ma-t-thias/ESP32-LED-Kopfhoererstaender/docs/hardware/schaltung.html

Projekt Arduino Kopfhörer · Schritt 1 Hardware

# WLED-Steuerung für den Kopfhörerständer: Schaltung und Bauteile

Waveshare ESP32-C6-Touch-LCD-1.9 steuert einen WS2812B-Streifen (5 V, 144 LEDs/m, später auf 60 bis 70 cm gekürzt) per WLAN. Versorgung über ein USB-C-Netzteil 5 V / 3 A. Aufbau auf zwei 400-Punkte-Breadboards BB-801, übereinander gesteckt. Pinbelegung geprüft gegen den Waveshare-Schaltplan des ESP32-C6-Touch-LCD-1.9 (Stiftleisten J3 und J4).

## Die fünf Entscheidungen

Datenpin GPIO3J3 Pin 7. Kein Strapping-Pin, nicht von LCD, SD, Touch, IMU oder USB belegt. GPIO1 und GPIO2 sind auf diesem Board die Interrupts des Lagesensors.

LED-Strom nie übers BreadboardBis zu 3 A fließen direkt USB-C-Buchse → WAGO → Streifen. Das Breadboard bekommt nur Signal und Logikversorgung.

Pegelwandler 74AHCT125Hebt das 3,3-V-Signal auf 5 V. WS2812B erwartet ab 0,7 × VDD = 3,5 V ein sicheres High.

Aura über Kabel an GPIO23Der ESP liest das ARGB-Signal des Mainboard-Headers mit. Ohne Signal laufen die eigenen Effekte.

Schottky-Diode vor dem VBUS-PinDer VBUS-Pin des Boards (J4 Pin 1) hängt direkt an USB-VBUS. D1 verhindert, dass das USB-C-Netzteil in den PC zurückspeist.

## Schaltplan

Das USB-C-Netzteil versorgt den Streifen direkt. Der ESP32 bekommt seine 5 V über D1, das Datensignal läuft von GPIO3 durch einen Puffer des 74AHCT125 und R1 zum DIN des Streifens. Alle Massen sind verbunden.

## Breadboard-Belegung (2 × BB-801)

+5 V GND GPIO3 (3,3 V) Daten 5 V zum Streifen ARGB-Daten vom Mainboard Dicke Linien rechts = Litze ≥ 1,0 mm²

Zwei Breadboards übereinander, Board 1 oben, Board 2 darunter. Reihen 1–30 von links nach rechts, Spalten j (oben) bis a (unten). Jede Reihe ist pro Hälfte (a–e und f–j) leitend verbunden. Der ESP überspannt beide Boards in den Reihen 1 bis 20: Display nach oben, USB-C-Anschluss Richtung Reihe 1, Stiftleiste J4 in Board 1 Spalte a, J3 in Board 2 Spalte j. Unter dem Display bleiben pro Reihe nur die freien Löcher Board 1 e (für J4) und Board 2 f (für J3) erreichbar, gelb markiert. Die Steuerung sitzt auf Board 1. Die USB-C-Buchse steckt auf Board 2 in Spalte a, Reihe 23 (GND) bis 30 (CC2), die Platine ragt über die untere Schiene. Der 74AHCT125 sitzt in den Reihen 23 bis 29 und überbrückt den Mittelkanal mit der Kerbe Richtung Reihe 29. Reihe 21 und 22 tragen den Spannungsteiler für das ARGB-Signal.

Vor dem Einstecken prüfen: Die beiden Stiftleisten liegen 17,78 mm (7 Rastermaße) auseinander, das passt genau auf Board 1 Spalte a und Board 2 Spalte j, wenn die Boards direkt aneinander stecken. Die M2-Abstandsbolzen (4 mm) auf der Rückseite begrenzen die Einstecktiefe, die Stifte greifen trotzdem sicher. Wenn es nicht sauber sitzt: Board neben das Breadboard legen und nur VBUS, GND, IO3 und IO23 mit vier Dupont-Kabeln (Buchse–Stecker) in Board 1 e1, e3, e9 und Board 2 f7 führen. Elektrisch ist das identisch. Kontrolliere außerdem die Aufschrift: In Board 1, Reihe 1, Spalte a muss der Pin „VBUS“ stecken (J4 Pin 1, direkt neben der USB-C-Buchse). Die USB-C-Buchse steckt nur zur Halterung im Breadboard. Die Litze für VBUS und GND lötest du oben an die Stifte der Buchse, so fließt der LED-Strom nicht über die Breadboard-Kontakte. Board 2, Reihe 23 und 24 (Spalte b bis e) liegen dadurch auf GND und 5 V, dort nichts anderes einstecken.

Von | Nach | Leitung | Zweck
ESP VBUS (J4/1, Board 1 a1) | D1 Kathode (Ring) in e1, Anode in f1 (über den Mittelkanal), j1 → obere + Schiene | Diode | ESP-Versorgung ohne Rückspeisung
ESP GND (J4/3, Board 1 a3) | e3 → obere − Schiene | blau | Gemeinsame Masse
ESP IO3 (J3/7, Board 2 j7) | Board 2 f7 → rechts am Display vorbei → Board 1 g28 (U1 Pin 2, 1A) | gelb | Datensignal 3,3 V
U1 Pin 3, 1Y (f27) | R1 330 Ω von h27 nach h30 | Widerstand | Dämpft Reflexionen, schützt DIN
j30 | Streifen DIN | grün | Datensignal 5 V
U1 Pin 1, 1OE̅ (f29) | j29 → obere − Schiene | blau | Kanal 1 dauerhaft aktiv
U1 Pin 7, GND (f23) | j23 → obere − Schiene | blau | IC-Masse
U1 Pin 14, VCC (e29) | a29 → untere + Schiene | rot | IC-Versorgung 5 V
C2 100 nF | b29 ↔ untere − Schiene | Kondensator | Abblockung direkt am IC
U1 Pin 4 (f26) / 10 (e25) / 13 (e28) | j26, a25, a28 → + Schiene | rot | Unbenutzte Kanäle abschalten
U1 Pin 5 (f25) / 9 (e24) / 12 (e27) | j25, a24, a27 → − Schiene | blau | Unbenutzte Eingänge nicht offen lassen
C1 1000 µF | + Bein in obere + Schiene, − Bein (Streifen) in obere − Schiene (Reihe 11/12) | Elko | Puffert Einschaltstrom und Lastsprünge
ESP IO23 (J4/9, Board 1 a9) | e9 → h21 | lila | ARGB-Eingang, Knoten des Spannungsteilers
Mainboard-ARGB D | i22, dann R3 1 kΩ von g22 nach g21 | lila | Aura-Signal, 5 V auf ca. 3,3 V geteilt
R4 2 kΩ | j21 → obere − Schiene | Widerstand | Unterer Teil des Spannungsteilers
Mainboard-ARGB G | obere − Schiene (Reihe 24) | grau | Gemeinsame Masse mit dem PC. Den 5V-Pin des Headers nicht anschließen.
obere Schienen | untere Schienen (+ zu +, − zu −) rechts ums Board | rot / blau | Beide Seiten versorgen
WAGO +5V / GND | obere + Schiene (Reihe 28) / obere − Schiene (Reihe 27) | dünn | Logikversorgung, unter 0,4 A
USB-C VBUS / GND (Board 2 a24 / a23) | oben an die Stifte gelötet → WAGO +5V / GND | Litze ≥ 1,0 mm² | Einspeisung, bis 3 A
USB-C D− / D+ (Board 2 a27 / a28) optional | e27 → f11 (ESP IO12, J3/11), e28 → f12 (ESP IO13, J3/12) | hellblau, gestrichelt | Nur für PC-Sync über USB (Adalight, siehe README). Dann den ESP nicht gleichzeitig über seine eigene USB-Buchse am PC haben.
WAGO +5V / GND | Streifen +5V / GND | Litze ≥ 1,0 mm² | LED-Strom bis 3 A

## Bauteilliste

Pos. | Bauteil | Wert / Typ | Menge | Dimensionierung und Hinweis
1 | Mikrocontroller vorhanden | Waveshare ESP32-C6-Touch-LCD-1.9 (Art.-Nr. 30941), Stiftleisten eingelötet | 1 | Zieht mit WLAN-Spitzen bis ca. 0,35 A.
2 | LED-Streifen vorhanden | WS2812B, 5 V, 144 LEDs/m, 1 m, IP30 | 1 | Wird auf 60 bis 70 cm gekürzt (ca. 86 bis 101 LEDs), nur an den Schnittmarken trennen. Max. ca. 60 mA pro LED bei vollem Weiß, ca. 1 mA pro LED auch im ausgeschalteten Zustand.
3 | Breadboard vorhanden | BB-801, 400 Kontakte | 2 | Übereinander gesteckt, weil das Display seitlich übersteht. Kontakte vertragen ca. 1 A. Deshalb kein LED-Strom über das Breadboard.
4 | USB-C-Netzteil | 5 V / 3 A (15 W), USB-C, z. B. offizielles Raspberry-Pi-4-Netzteil (5,1 V / 3 A) | 1 | Ein normales USB-C-Ladegerät mit 5 V / 3 A geht auch. Wichtig ist 3 A bei 5 V, viele Handy-Ladegeräte liefern bei 5 V nur 2 A. Strombegrenzung in der Firmware auf 2400 mA.
5 | Pegelwandler U1 | 74AHCT125N (DIP-14) | 1 | Gleichwertig: 74HCT125N oder 74HCT245N. Kein 74HC125 (falsche Eingangsschwelle) und kein MOSFET-Modul für I²C (zu langsam für 800 kHz).
6 | Widerstand R1 | 330 Ω, 0,25 W | 1 | Zulässig 220 bis 470 Ω. Im Endaufbau möglichst nah an den Streifen setzen.
7 | Elko C1 | 1000 µF, ≥ 10 V, radial | 1 | Polung beachten: Streifen am Gehäuse = Minus. Im Endaufbau direkt an den Streifeneingang löten.
8 | Keramikkondensator C2 | 100 nF | 1 | Abblockkondensator am 74AHCT125, so nah wie möglich an Pin 14.
9 | Schottky-Diode D1 | 1N5819 (oder 1N5817), 1 A | 1 | Ring (Kathode) zum ESP. Der ESP bekommt dann ca. 4,7 V, das reicht für seinen 3,3-V-Regler.
10 | USB-C-Buchse (Power-Breakout) vorhanden | QUARKZMAN USB-C-Breakout, 8 Stifte im 2,54-mm-Raster: GND, VBUS, SBU2, CC1, D−, D+, SBU1, CC2. 5,1 kΩ an CC1 und CC2 sind auf der Platine (Aufdruck „512“). | 1 | Gekauft bei Amazon B0CJC5M66Q (https://www.amazon.de/dp/B0CJC5M66Q). Ohne die CC-Widerstände schaltet ein USB-C-Netzteil keine Spannung ein. Beim Kauf auf „5,1 kΩ“ oder „CC-Widerstände“ achten, die einfachen 2-Pin-Platinen haben sie oft nicht. Kein PD-Trigger nötig.
11 | Verbindungsklemmen | WAGO 221-413 (3-fach) | 2 | Je eine für +5 V und GND: USB-C-Buchse, Streifen, Breadboard.
12 | Litze | 1,0 mm² (AWG 18), rot und schwarz | je 0,5 m | Für den Strompfad USB-C-Buchse → Streifen. 0,75 mm² reicht bei 3 A auch.
13 | Steckverbinder Streifen | JST-SM 3-polig, Gegenstück zum Eingang | 1 | Optional, wenn du die offenen Litzen am Streifen nicht direkt in die WAGO-Klemme führen willst.
14 | Steckbrücken | Jumper Stecker–Stecker, Drahtbrückenset | ca. 18 | Plus 4 × Buchse–Stecker als Reserve für die Variante „Board neben dem Breadboard“.
15 | ARGB-Kabel | 3-polige ARGB-Verlängerung (5V, D, G) mit Buchse für den Mainboard-Header | 1 | Ende abschneiden, nur D und G nutzen. So steuert ASUS Aura den Ständer.
16 | Widerstände R3, R4 | 1 kΩ und 2 kΩ | je 1 | Spannungsteiler: 5 V × 2 / 3 = 3,3 V am GPIO23. Ersatzweise 3 × 1 kΩ, zwei davon in Reihe als 2 kΩ.
17 | Sicherung optional | Feinsicherung oder KFZ-Flachsicherung 4 A mit Halter | 1 | In die +5-V-Leitung nach der USB-C-Buchse. USB-C-Netzteile schalten bei Überlast meist selbst ab.

## Netzteil-Dimensionierung

≈ 6 A100 LEDs (70 cm) × 60 mA, Vollweiß 100 %

≈ 0,35 AESP32-C6 mit WLAN-Spitzen

2,4 AStrombegrenzung bei 5 V / 3 A, Rest für ESP und Reserve

0,5–2 ATypischer Bedarf bei Farbverläufen und Effekten

Die Firmware begrenzt die Helligkeit so, dass der berechnete Strom 2400 mA nicht überschreitet (WLED nennt das „Automatic Brightness Limiter“). Farbige Effekte laufen damit in voller Helligkeit. Nur Vollweiß auf allen LEDs wird auf etwa 40 % gedimmt. Wer mehr will, nimmt ein USB-C-PD-Ladegerät (30 bis 65 W) mit PD-Trigger auf 12 V und einen Step-down-Wandler auf 5 V mit mindestens 6 A, die Strombegrenzung dann auf etwa 85 % des Wandlerstroms.

## Prüfen vor dem ersten Einschalten

1. Ohne ESP, IC und Streifen: USB-C-Netzteil einstecken und an den Schienen messen. Erwartet sind 4,9 bis 5,25 V. Liegt 0 V an, fehlen der Buchse die CC-Widerstände. Plus oben und unten an der roten Linie.
2. 74AHCT125 einsetzen: Pin 14 gegen Pin 7 muss 5 V zeigen. Kerbe zeigt Richtung Reihe 29.
3. D1 kontrollieren: Ring in Board 1 e1, Anode in f1. Mit USB-C-Netzteil an und ohne USB am ESP misst du an e1 ca. 4,7 V.
4. C1-Polung kontrollieren: Minus-Streifen auf der blauen Schiene.
5. Streifen am Eingang anschließen: Die Pfeile auf dem Streifen zeigen vom DIN-Ende weg.
6. Reihenfolge beim Anschließen: zuerst GND und +5 V, dann die Datenleitung. Das Datensignal nie an einen unversorgten Streifen legen.
7. Zum Flashen darfst du die USB-Buchse des ESP und das USB-C-Netzteil gleichzeitig verbinden. D1 sperrt dann, der ESP läuft über USB, die Massen sind über die gemeinsame GND-Schiene verbunden.

## Pinbelegung des Boards (aus dem Waveshare-Schaltplan)

Leiste | Pins | Verwendung hier
J4 (Board 1 Spalte a) | 1 VBUS · 2 VSYS · 3 GND · 4 3V3_EN · 5 3V3 · 6 ADC_VREF · 7 IO22 · 8 GND · 9 IO23 · 10 EXIO0 · 11 RUN · 12 EXIO1 · 13 GND · 14–17 EXIO2–5 · 18 GND · 19–20 EXIO6–7 | Pin 1 VBUS über D1, Pin 3 GND, Pin 9 IO23 = ARGB-Eingang vom Mainboard. EXIO sind Ausgänge des I²C-Expanders TCA9554, für WS2812B nicht geeignet.
J3 (Board 2 Spalte j) | 1 IO16 · 2 IO17 · 3 GND · 4 IO0 · 5 IO1 · 6 IO2 · 7 IO3 · 8 GND · 9 IO8 · 10 IO9 · 11 IO12 · 12 IO13 · 13 GND · 14 IO14 · 15 IO15 · 16 IO18 · 17 IO19 · 18 GND · 19 IO20 · 20 IO21 | Pin 7 IO3 = LED-Daten. 16/17 UART0, 12/13 USB, 0 Akku-ADC, 1/2 IMU-Interrupt, 8/18 Touch-I²C, 9/15 Strapping, 14/15 LCD, 19/20 SD-Karte. Nicht benutzen.
Intern belegt | LCD 4/5/6/7/14/15 · Touch + IMU I²C 8/18 · IMU-INT 1/2 · SD 19/20 · BOOT 9 | Pin 1 beider Leisten liegt an der USB-C-Seite.

Stand 7. November 2026. Board: ESP32-C6-Touch-LCD-1.9, LED-Daten an GPIO3, ARGB-Eingang an GPIO23.
