ma-t-thias/ESP32-LED-Kopfhoererstaender/docs/hardware/platine/out/platine_aetzvorlage_A4.pdf

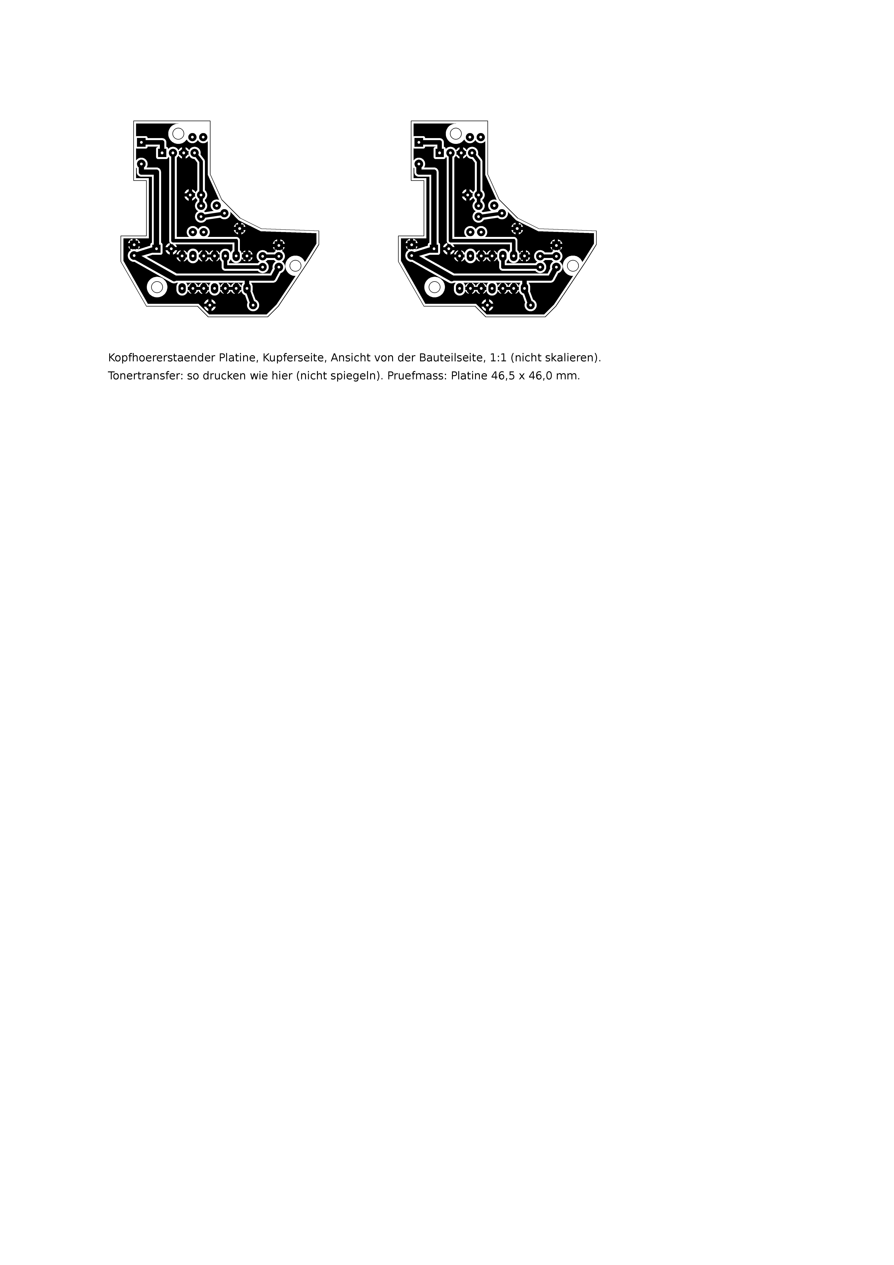
[picture p34: page 1]
