ma-t-thias/ESP32-LED-Kopfhoererstaender/docs/hardware/gehaeuse/c6-lcd-1.3/bilder/view_front.png

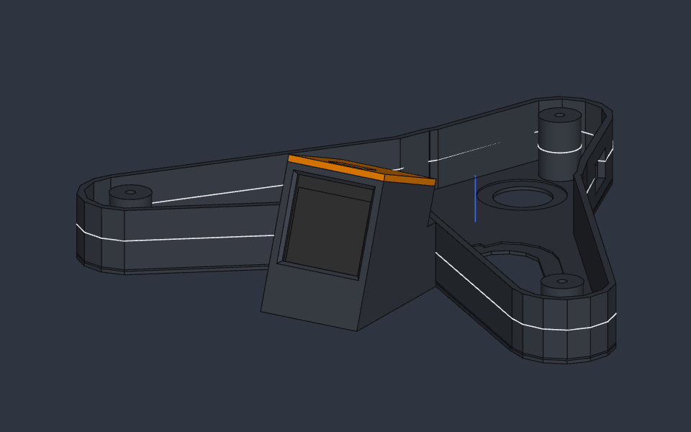
docs/hardware/gehaeuse/c6-lcd-1.3/bilder/view_front.png
