ma-t-thias/ESP32-LED-Kopfhoererstaender/docs/hardware/gehaeuse/c6-lcd-1.3/bilder/view_section_rail.png

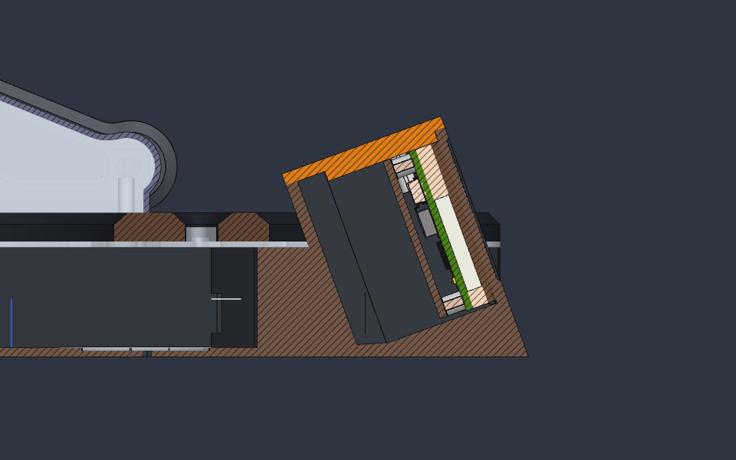
docs/hardware/gehaeuse/c6-lcd-1.3/bilder/view_section_rail.png
