ma-t-thias/ESP32-LED-Kopfhoererstaender/docs/hardware/gehaeuse/c6-touch-1.9/hochkant/bilder/asm_section.png

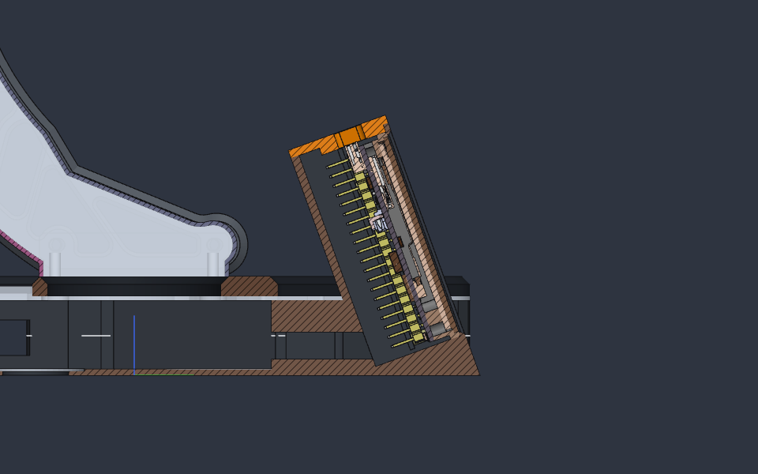
docs/hardware/gehaeuse/c6-touch-1.9/hochkant/bilder/asm_section.png
