ma-t-thias/ESP32-LED-Kopfhoererstaender/docs/hardware/gehaeuse/c6-touch-1.9/quer/bilder/quer_frontb_front.png

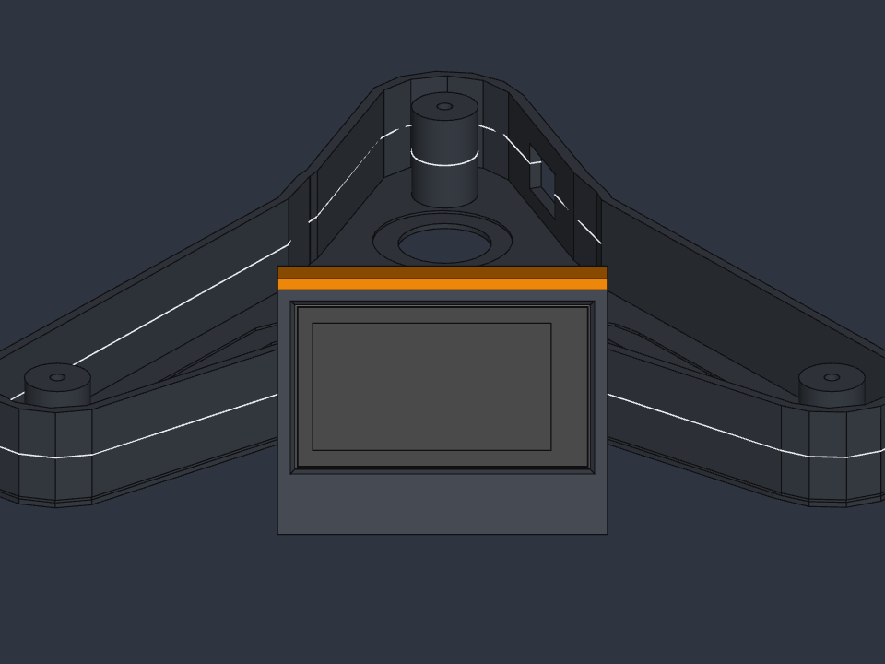
docs/hardware/gehaeuse/c6-touch-1.9/quer/bilder/quer_frontb_front.png
