ma-t-thias/ESP32-LED-Kopfhoererstaender/docs/hardware/gehaeuse/staender-v2/entwurf-1/Auflage_v2_schnitt.png

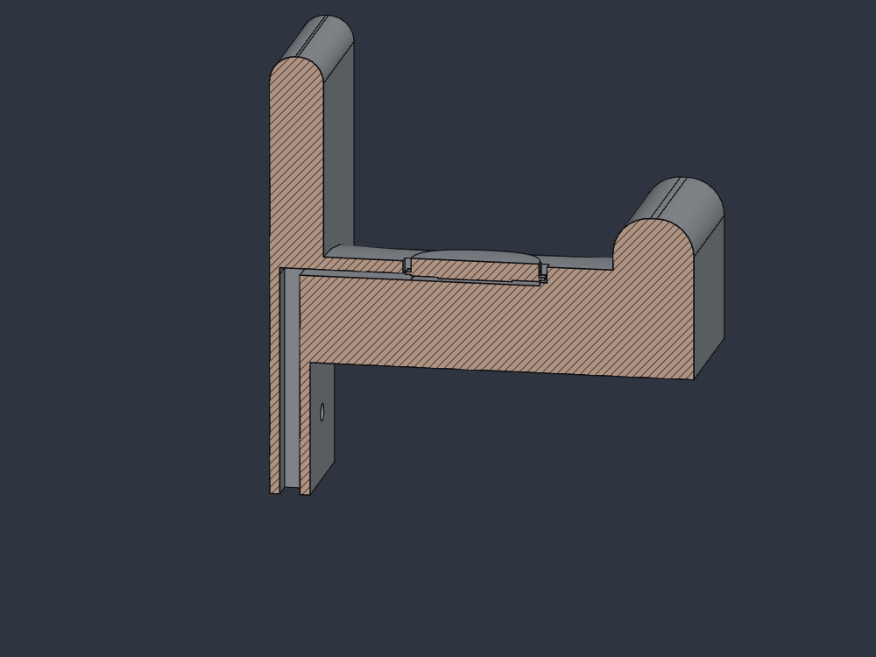
docs/hardware/gehaeuse/staender-v2/entwurf-1/Auflage_v2_schnitt.png
