ma-t-thias/ESP32-LED-Kopfhoererstaender/docs/hardware/gehaeuse/staender-v2/entwurf-1/Deckel_Mikrohalter_innen.png

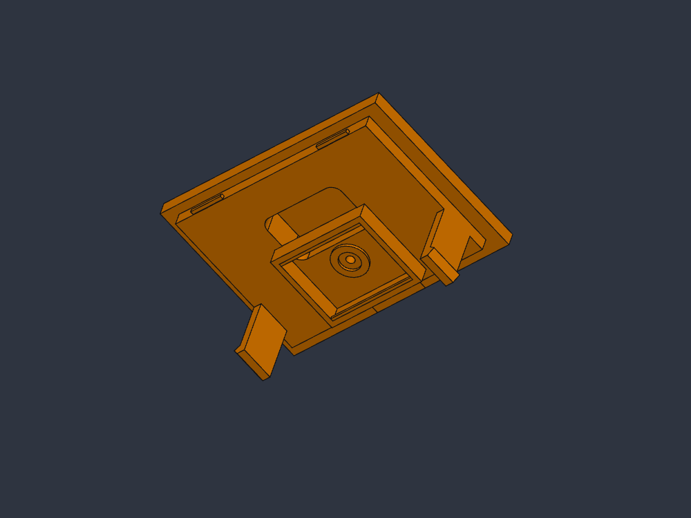
docs/hardware/gehaeuse/staender-v2/entwurf-1/Deckel_Mikrohalter_innen.png
