ma-t-thias/ESP32-LED-Kopfhoererstaender/docs/hardware/gehaeuse/staender-v2/entwurf-1/Saeule_Fenster_rund.png

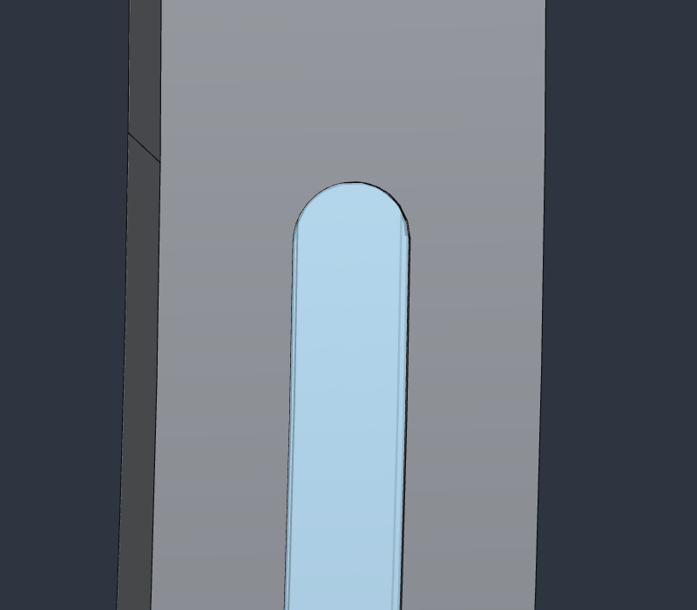
docs/hardware/gehaeuse/staender-v2/entwurf-1/Saeule_Fenster_rund.png
