ma-t-thias/ESP32-LED-Kopfhoererstaender/docs/hardware/gehaeuse/staender-v2/entwurf-1/Sockel_oval_iso.png

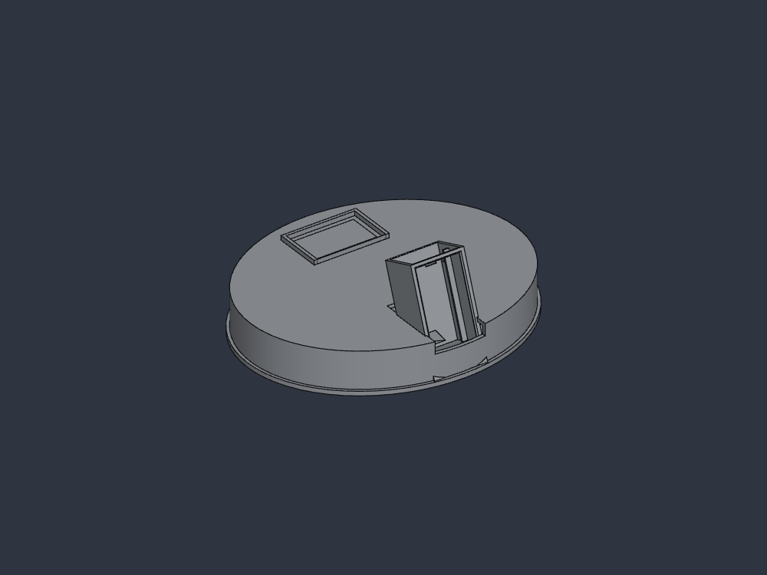
docs/hardware/gehaeuse/staender-v2/entwurf-1/Sockel_oval_iso.png
