ma-t-thias/ESP32-LED-Kopfhoererstaender/docs/hardware/gehaeuse/staender-v2/entwurf-1/Sockel_unten_Fuesse.png

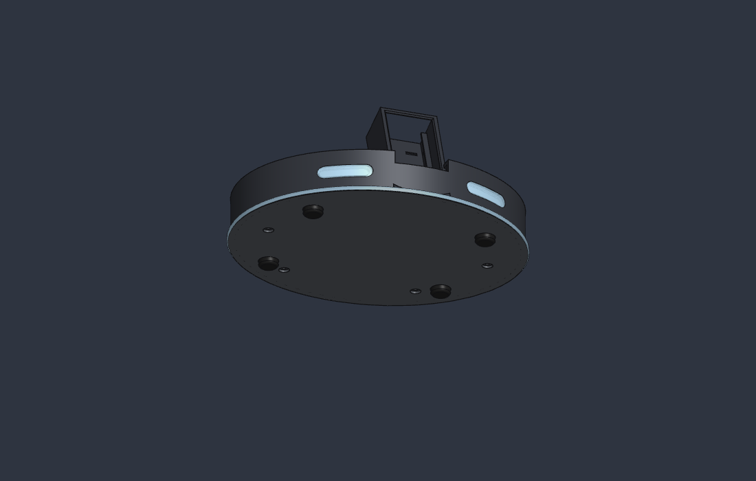
docs/hardware/gehaeuse/staender-v2/entwurf-1/Sockel_unten_Fuesse.png
