ma-t-thias/ESP32-LED-Kopfhoererstaender/docs/hardware/gehaeuse/staender-v2/entwurf-1/USB_C_Halter_Schnitt.png

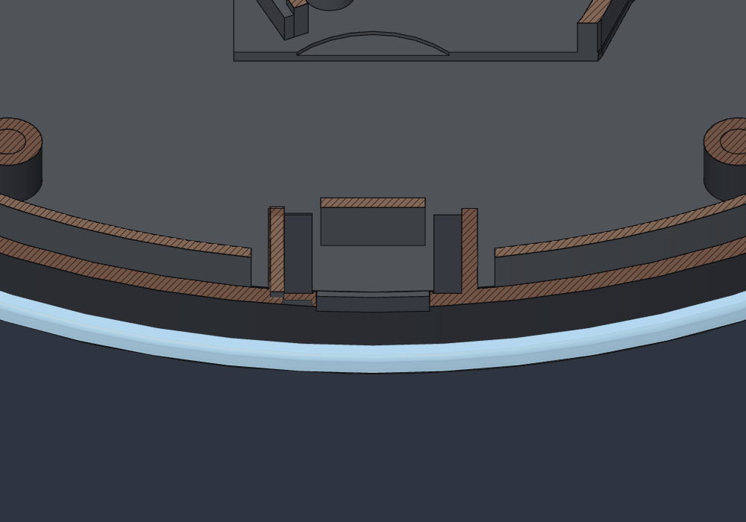
docs/hardware/gehaeuse/staender-v2/entwurf-1/USB_C_Halter_Schnitt.png
