ma-t-thias/ESP32-LED-Kopfhoererstaender/docs/hardware/platine/out/platine_aetzvorlage_600dpi.png

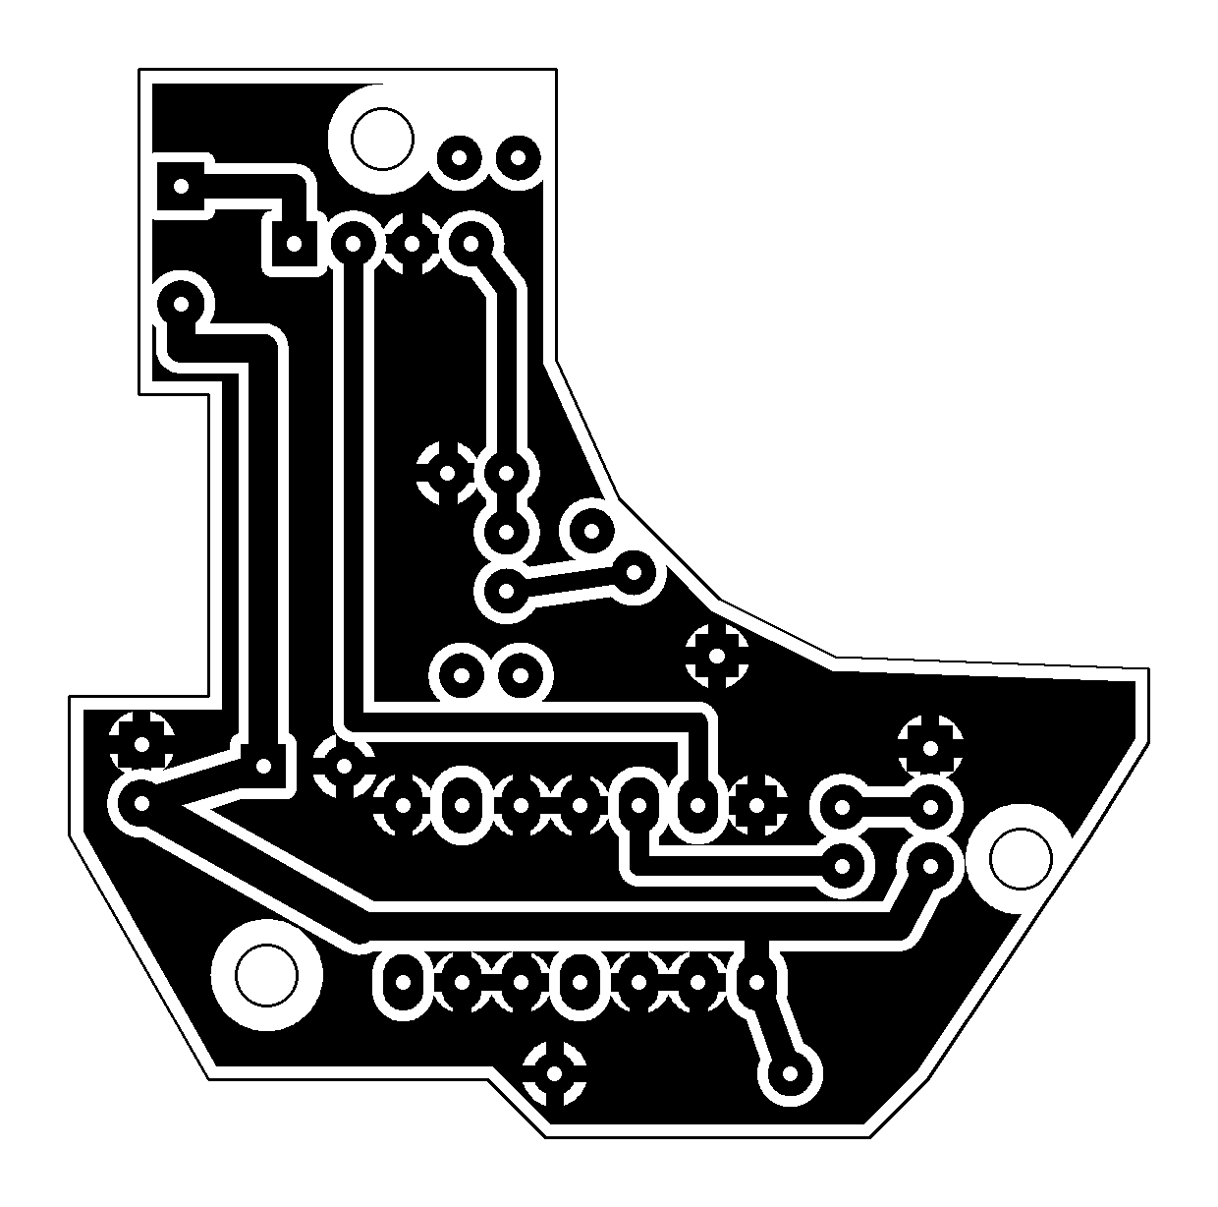
docs/hardware/platine/out/platine_aetzvorlage_600dpi.png
