ma-t-thias/ESP32-LED-Kopfhoererstaender/docs/hardware/gehaeuse/c6-lcd-1.3/cad/RGB Headphone Stand - Baugruppe.3mf

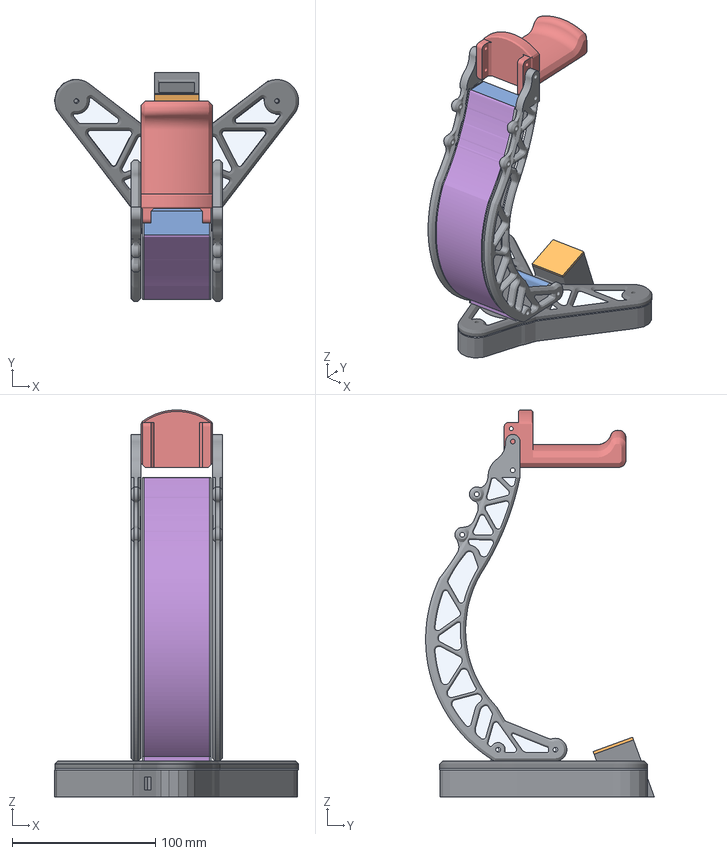
[picture p61: CAD file, 2026-11-02]
docs/hardware/gehaeuse/c6-lcd-1.3/cad/RGB Headphone Stand - Baugruppe.3mf
170.4 x 159.6 x 270.0 mm
Base_Box_ESP32
ESP32_Lid
Diffuser_base
1_Base
Front_Cover
Back_Cover
Side_Diffuser_LEFT
Side_Diffuser_RIGHT
Diffuser_box
Side_Left
Side_Right
Headphone_Post_Mount
