ma-t-thias/ESP32-LED-Kopfhoererstaender/docs/hardware/gehaeuse/c6-touch-1.9/quer/cad/Baugruppe_quer.3mf

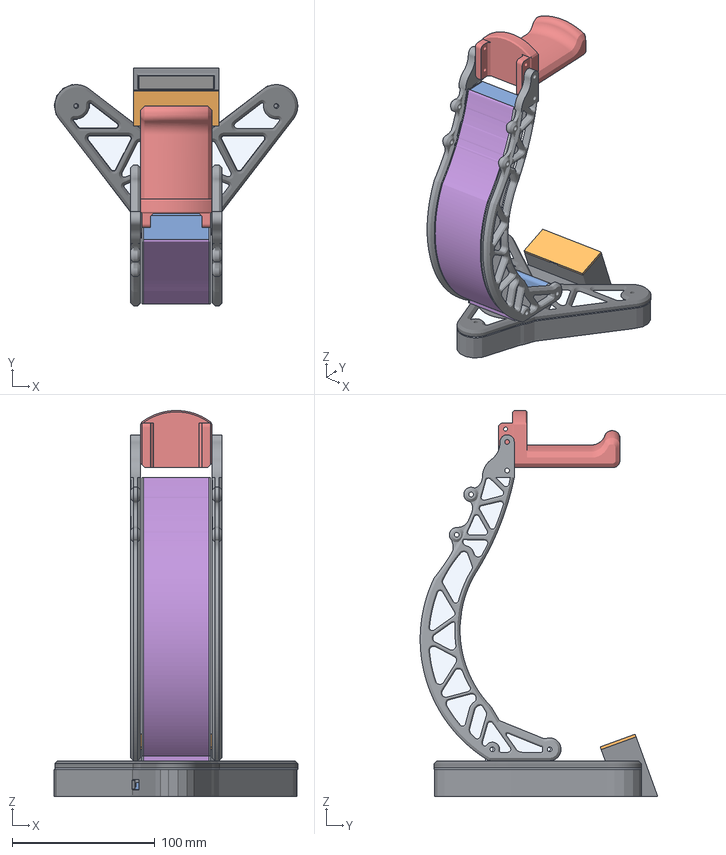
[picture p63: CAD file, 2026-11-10]
docs/hardware/gehaeuse/c6-touch-1.9/quer/cad/Baugruppe_quer.3mf
170.4 x 166.2 x 270.0 mm
Base_Box_ESP32
ESP32_Lid
USB_C_Breakout_Dummy
U1_74AHCT125
R1_330
C2_100nF_CY630
PCB_Elektronik
R3_1k
R4_2k
Stiftleiste_ESP
C1_1000uF_8x16_7
C1_Beine
C1_Beine (2)
C1_Beine_2
C1_Beine_2 (2)
PCB_Pads
PCB_Pads (2)
PCB_Pads (3)
PCB_Pads (4)
PCB_Pads (5)
PCB_Pads (6)
PCB_Pads (7)
PCB_Pads (8)
PCB_Pads (9)
PCB_Pads (10)
PCB_Pads (11)
PCB_Pads (12)
PCB_Pads (13)
PCB_Pads (14)
PCB_Pads (15)
PCB_Pads (16)
PCB_Pads (17)
PCB_Pads (18)
PCB_Pads (19)
PCB_Pads (20)
PCB_Pads (26)
PCB_Pads (27)
PCB_Pads (28)
PCB_Pads (29)
PCB_Pads (30)
PCB_Pads (31)
PCB_Pads (32)
PCB_Pads (33)
PCB_Pads (34)
PCB_Pads (35)
PCB_Pads (36)
PCB_Pads (37)
PCB_Pads (38)
D1_1N5819
Stiftleiste_ARGB_90
ARGB90_Pin_5V
ARGB90_Pin_D
ARGB90_Pin_G
ARGB90_Bein_5V
ARGB90_Bein_D
ARGB90_Bein_G
ARGB_Buchsenstecker
Stiftleiste_USB_Strom
Stift_USB_Strom_1
Stift_USB_Strom_2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
