ma-t-thias/ESP32-LED-Kopfhoererstaender/docs/hardware/gehaeuse/c6-lcd-1.3/drucken/ESP32_Lid.stl

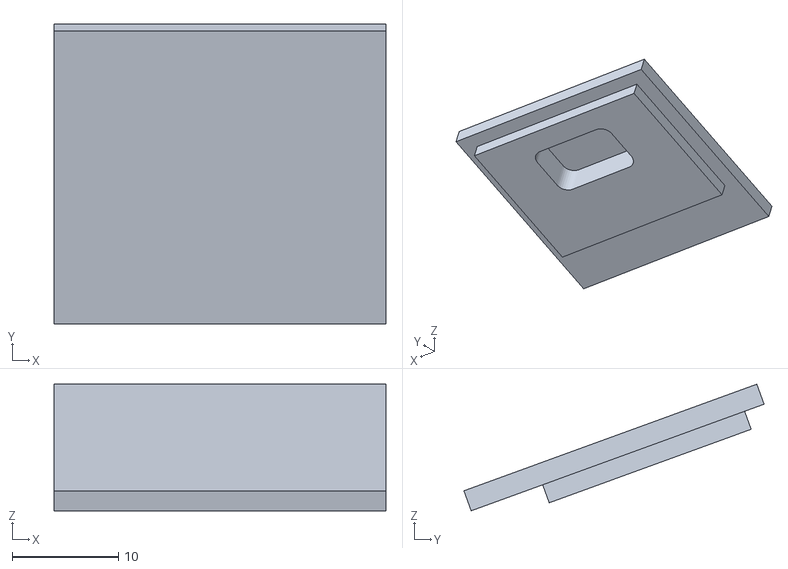
[picture p64: CAD file, 2026-11-02]
docs/hardware/gehaeuse/c6-lcd-1.3/drucken/ESP32_Lid.stl
31.2 x 28.2 x 11.9
