ma-t-thias/ESP32-LED-Kopfhoererstaender/docs/hardware/gehaeuse/c6-touch-1.9/hochkant/drucken/RGB Headphone Stand - ESP32.3mf

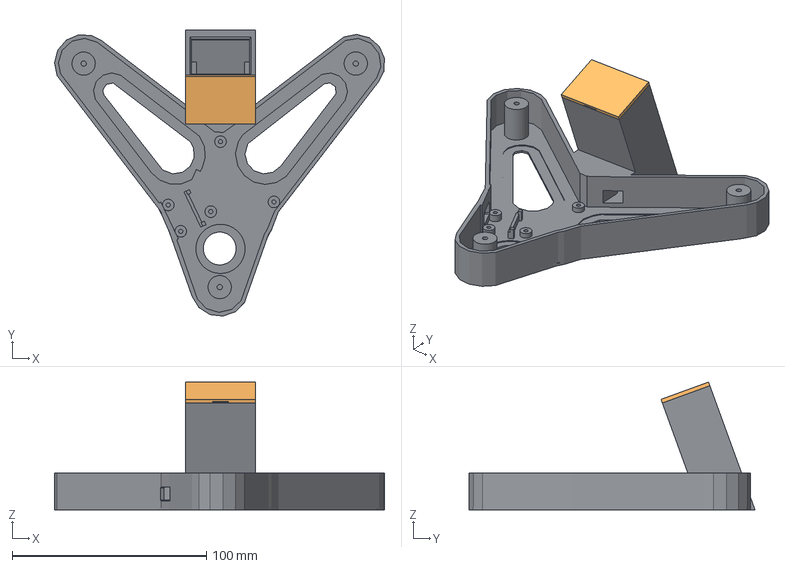
[picture p65: CAD file, 2026-11-10]
docs/hardware/gehaeuse/c6-touch-1.9/hochkant/drucken/RGB Headphone Stand - ESP32.3mf
169.8 x 147.2 x 65.8 mm
Base_Box_ESP32
ESP32_Lid
