ma-t-thias/ESP32-LED-Kopfhoererstaender/docs/hardware/gehaeuse/c6-touch-1.9/quer/drucken/ESP32_Lid_quer.stl

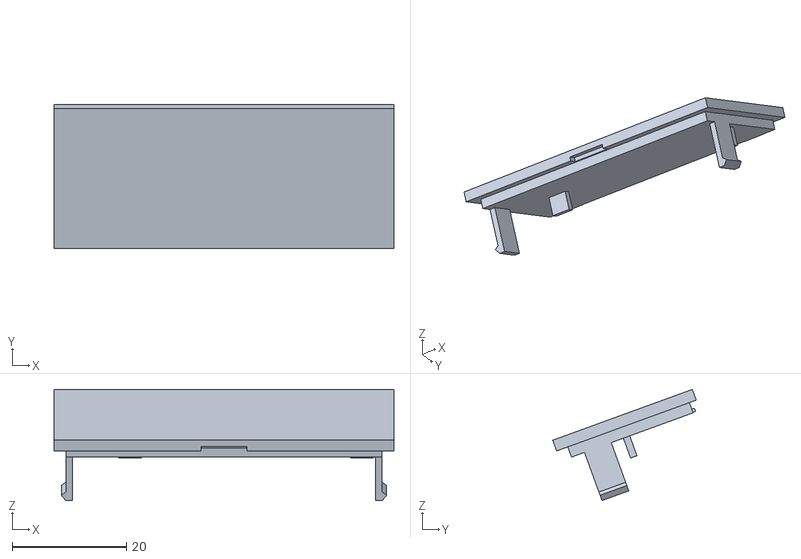
[picture p66: CAD file, 2026-11-10]
docs/hardware/gehaeuse/c6-touch-1.9/quer/drucken/ESP32_Lid_quer.stl
59.6 x 25.2 x 19.5
