ma-t-thias/ESP32-LED-Kopfhoererstaender/docs/hardware/gehaeuse/staender-v2/entwurf-1/Passprobe_v2_Inlay_Saeule_oben.stl

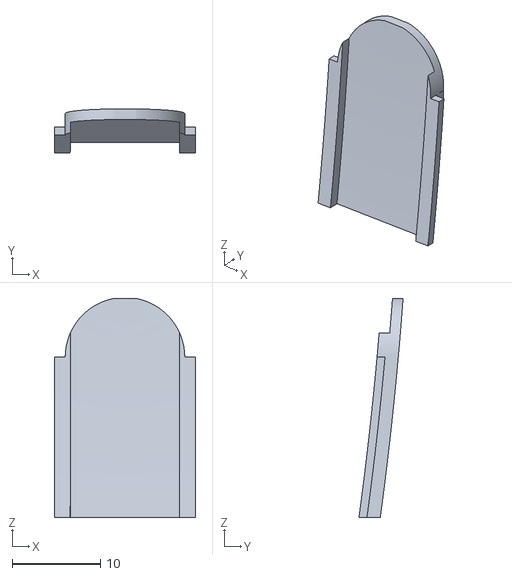
[picture p67: CAD file, 2026-11-14]
docs/hardware/gehaeuse/staender-v2/entwurf-1/Passprobe_v2_Inlay_Saeule_oben.stl
16.0 x 5.00 x 24.8
