ma-t-thias/ESP32-LED-Kopfhoererstaender/docs/hardware/gehaeuse/c6-lcd-1.3/drucken/RGB Headphone Stand - ESP32.3mf

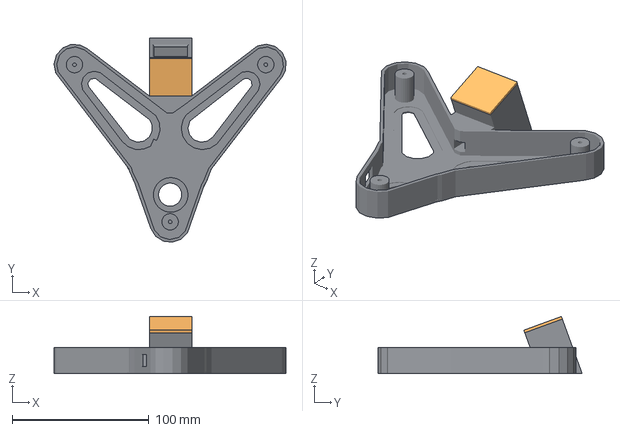
[picture p68: CAD file, 2026-11-02]
docs/hardware/gehaeuse/c6-lcd-1.3/drucken/RGB Headphone Stand - ESP32.3mf
169.8 x 149.6 x 41.7 mm
Base_Box_ESP32
ESP32_Lid
