ma-t-thias/ESP32-LED-Kopfhoererstaender/docs/hardware/gehaeuse/c6-touch-1.9/hochkant/drucken/ESP32_Lid.stl

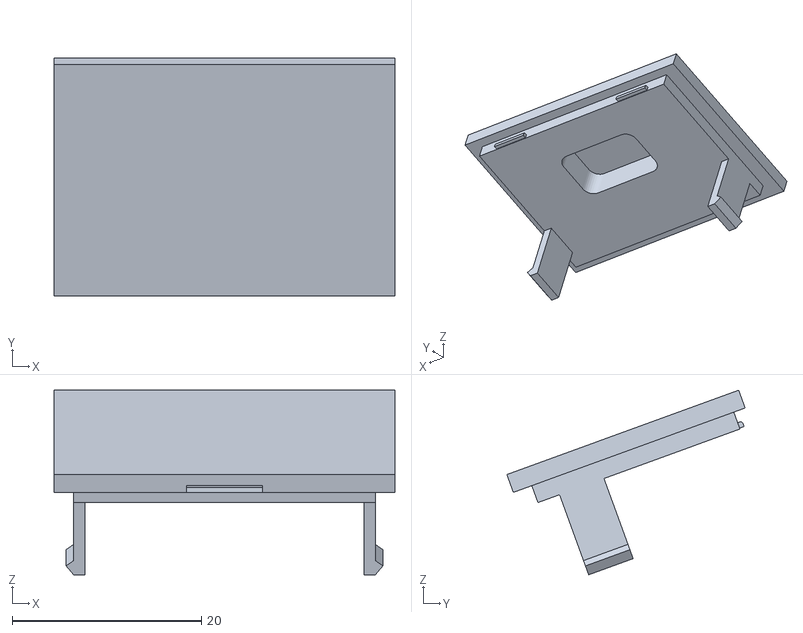
[picture p69: CAD file, 2026-11-10]
docs/hardware/gehaeuse/c6-touch-1.9/hochkant/drucken/ESP32_Lid.stl
36.0 x 25.2 x 19.5
