ma-t-thias/ESP32-LED-Kopfhoererstaender/docs/hardware/gehaeuse/c6-touch-1.9/quer/drucken/Base_Box_ESP32_quer.stl

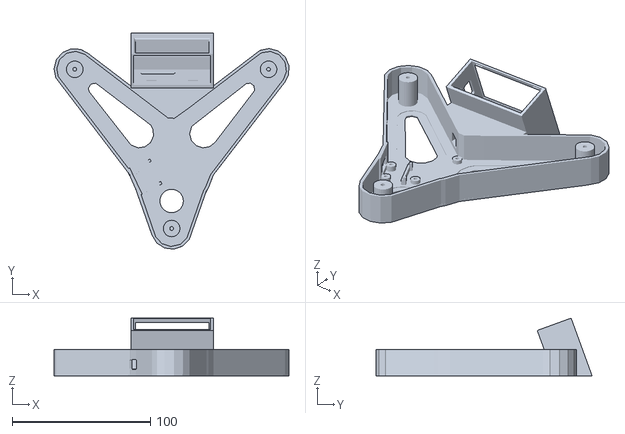
[picture p70: CAD file, 2026-11-10]
docs/hardware/gehaeuse/c6-touch-1.9/quer/drucken/Base_Box_ESP32_quer.stl
169.8 x 156.2 x 41.7
