ma-t-thias/ESP32-LED-Kopfhoererstaender/docs/hardware/gehaeuse/staender-v2/entwurf-1/ESP32_Lid_Mikro_quer.stl

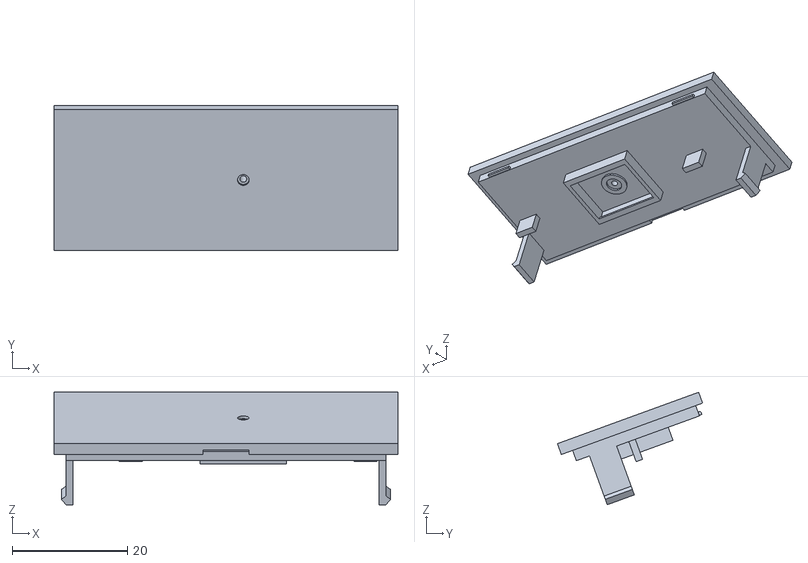
[picture p71: CAD file, 2026-11-14]
docs/hardware/gehaeuse/staender-v2/entwurf-1/ESP32_Lid_Mikro_quer.stl
59.6 x 25.2 x 19.5
