ma-t-thias/ESP32-LED-Kopfhoererstaender/docs/hardware/gehaeuse/c6-lcd-1.3/drucken/Base_Box_ESP32.stl

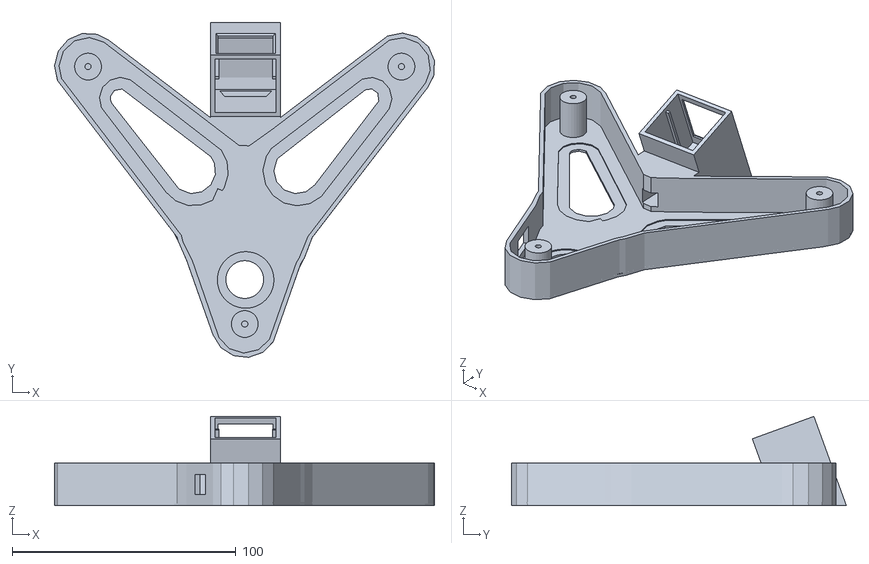
[picture p72: CAD file, 2026-11-02]
docs/hardware/gehaeuse/c6-lcd-1.3/drucken/Base_Box_ESP32.stl
169.8 x 149.6 x 39.8
