ma-t-thias/ESP32-LED-Kopfhoererstaender/docs/hardware/gehaeuse/c6-touch-1.9/hochkant/drucken/Base_Box_ESP32.stl

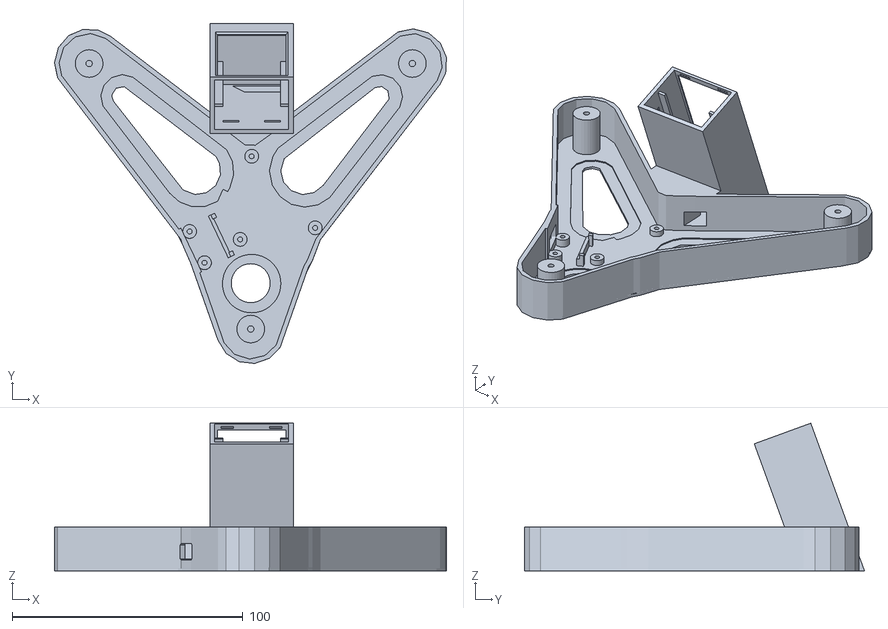
[picture p73: CAD file, 2026-11-10]
docs/hardware/gehaeuse/c6-touch-1.9/hochkant/drucken/Base_Box_ESP32.stl
169.8 x 147.2 x 63.9
