ma-t-thias/ESP32-LED-Kopfhoererstaender/docs/hardware/gehaeuse/c6-touch-1.9/quer/drucken/ESP32_quer.3mf

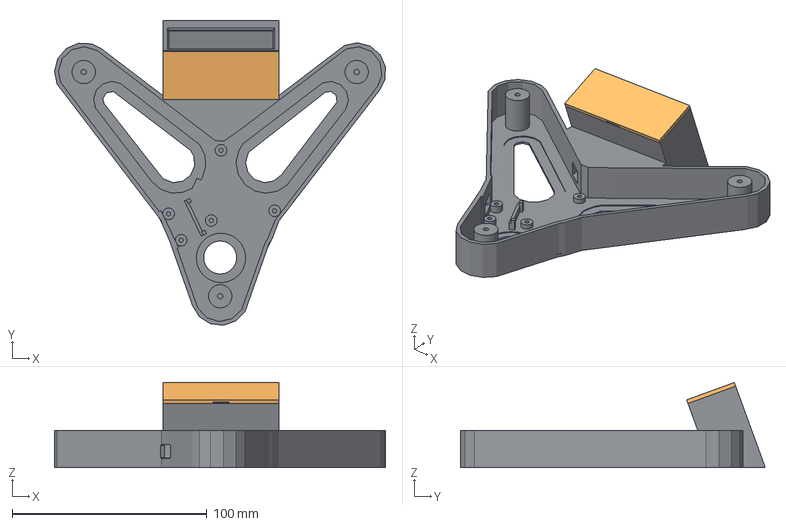
[picture p74: CAD file, 2026-11-10]
docs/hardware/gehaeuse/c6-touch-1.9/quer/drucken/ESP32_quer.3mf
169.8 x 156.2 x 43.6 mm
Base_Box_ESP32
ESP32_Lid
