ma-t-thias/ESP32-LED-Kopfhoererstaender/docs/hardware/gehaeuse/staender-v2/entwurf-1/Saeule_v2.stl

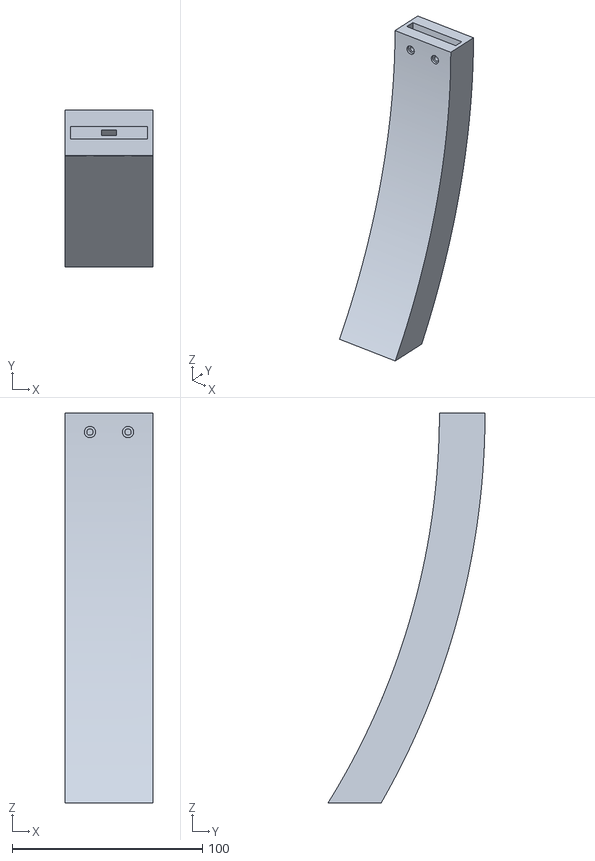
[picture p75: CAD file, 2026-11-14]
docs/hardware/gehaeuse/staender-v2/entwurf-1/Saeule_v2.stl
46.0 x 82.6 x 205.0
