ma-t-thias/ESP32-LED-Kopfhoererstaender/docs/hardware/gehaeuse/staender-v2/entwurf-1/Inlay_Leuchtring.stl

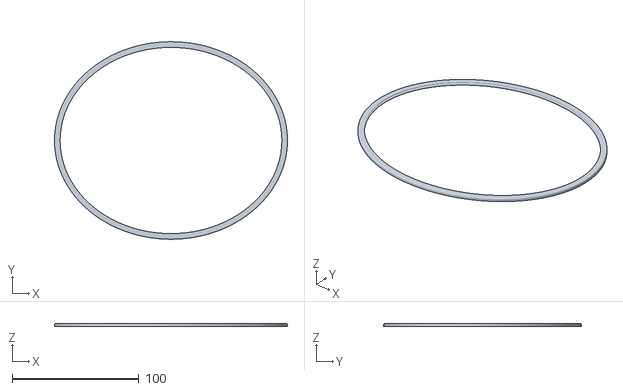
[picture p76: CAD file, 2026-11-14]
docs/hardware/gehaeuse/staender-v2/entwurf-1/Inlay_Leuchtring.stl
184.0 x 156.0 x 2.40
