ma-t-thias/ESP32-LED-Kopfhoererstaender/docs/hardware/gehaeuse/staender-v2/entwurf-1/Passprobe_v2_Saeule_oben.stl

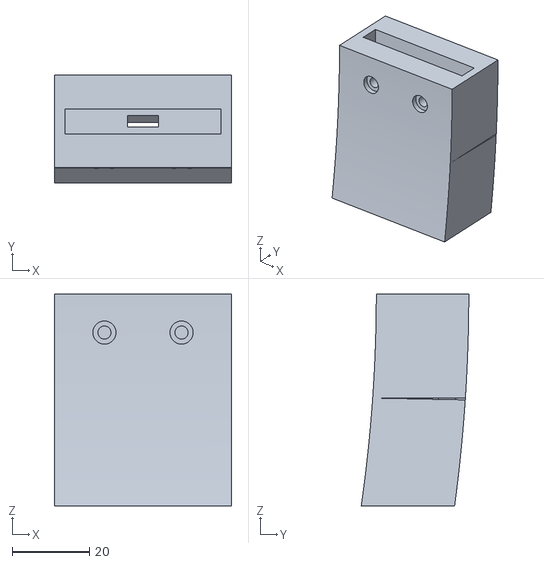
[picture p77: CAD file, 2026-11-14]
docs/hardware/gehaeuse/staender-v2/entwurf-1/Passprobe_v2_Saeule_oben.stl
46.0 x 27.9 x 55.0
