ma-t-thias/ESP32-LED-Kopfhoererstaender/docs/hardware/gehaeuse/staender-v2/entwurf-1/Inlay_Front_links.stl

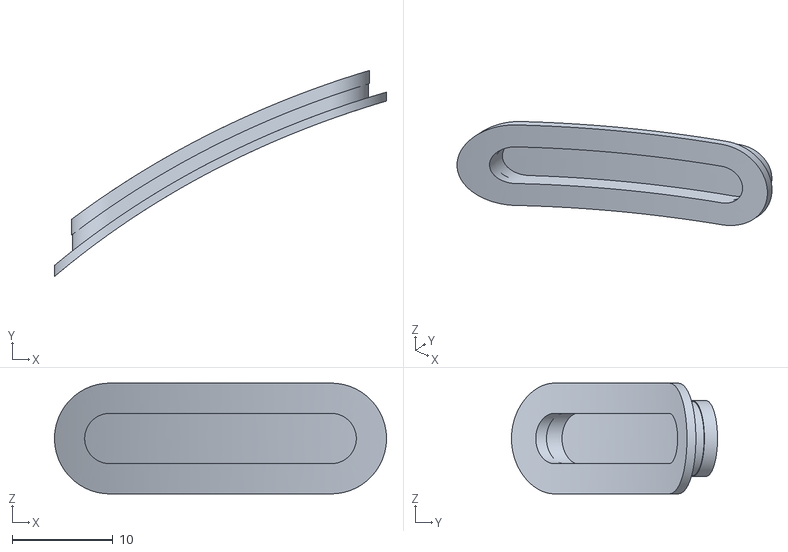
[picture p78: CAD file, 2026-11-14]
docs/hardware/gehaeuse/staender-v2/entwurf-1/Inlay_Front_links.stl
33.0 x 20.5 x 11.0
