ma-t-thias/ESP32-LED-Kopfhoererstaender/docs/hardware/gehaeuse/staender-v2/entwurf-1/Sockel_oval_v1.stl

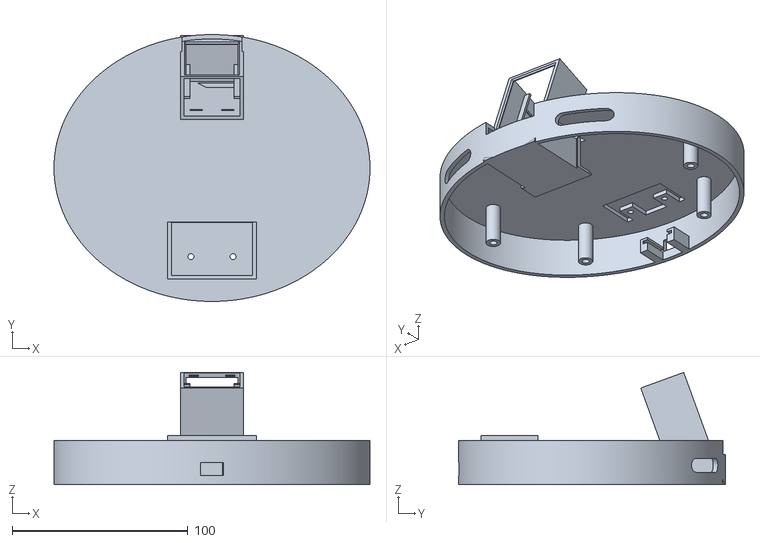
[picture p79: CAD file, 2026-11-14]
docs/hardware/gehaeuse/staender-v2/entwurf-1/Sockel_oval_v1.stl
180.0 x 152.0 x 63.9
