ma-t-thias/ESP32-LED-Kopfhoererstaender/docs/hardware/gehaeuse/staender-v2/entwurf-1/Boden_v1.stl

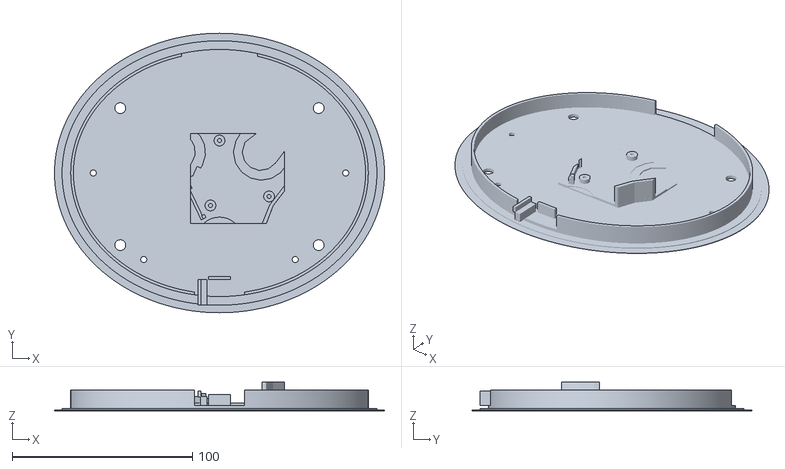
[picture p80: CAD file, 2026-11-14]
docs/hardware/gehaeuse/staender-v2/entwurf-1/Boden_v1.stl
183.0 x 155.0 x 15.9
