ma-t-thias/ESP32-LED-Kopfhoererstaender/docs/hardware/gehaeuse/staender-v2/entwurf-1/ESP32_Lid_Mikro_hochkant.stl

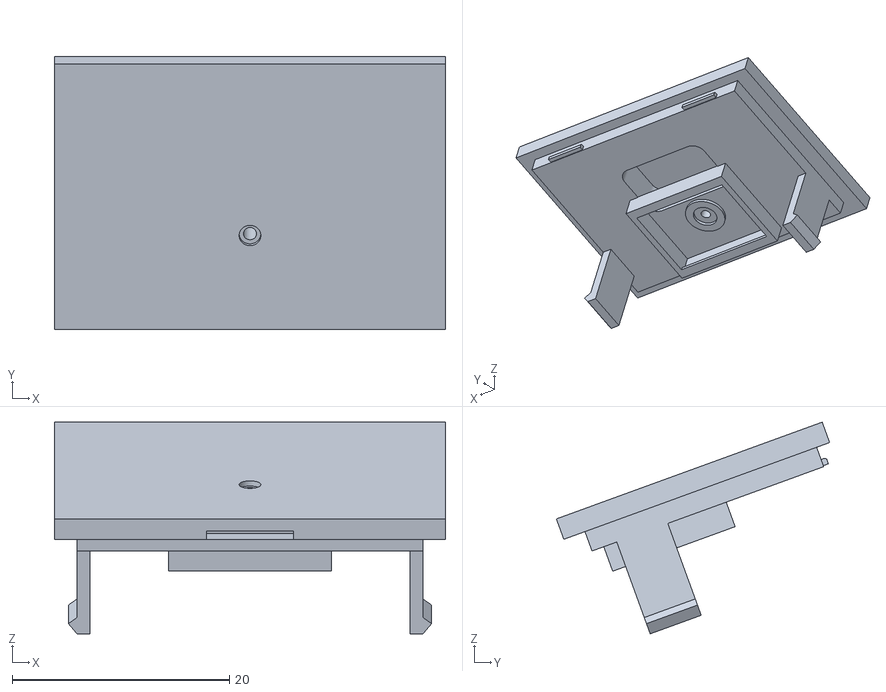
[picture p81: CAD file, 2026-11-14]
docs/hardware/gehaeuse/staender-v2/entwurf-1/ESP32_Lid_Mikro_hochkant.stl
36.0 x 25.2 x 19.5
