ma-t-thias/ESP32-LED-Kopfhoererstaender/docs/hardware/gehaeuse/staender-v2/entwurf-1/Druckplatte_FSR.stl

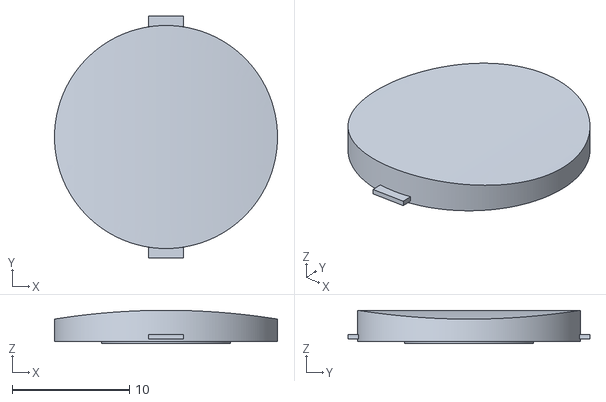
[picture p82: CAD file, 2026-11-14]
docs/hardware/gehaeuse/staender-v2/entwurf-1/Druckplatte_FSR.stl
19.0 x 20.6 x 2.85
