ma-t-thias/ESP32-LED-Kopfhoererstaender/docs/hardware/gehaeuse/staender-v2/entwurf-1/Auflage_v2.stl

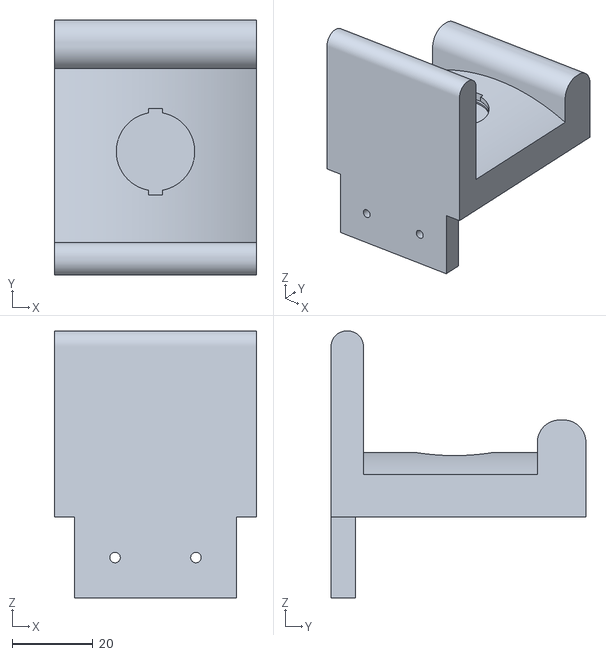
[picture p83: CAD file, 2026-11-14]
docs/hardware/gehaeuse/staender-v2/entwurf-1/Auflage_v2.stl
50.0 x 63.0 x 66.0
