ma-t-thias/ESP32-LED-Kopfhoererstaender/docs/hardware/gehaeuse/staender-v2/entwurf-1/TPU_Fuss_4x.stl

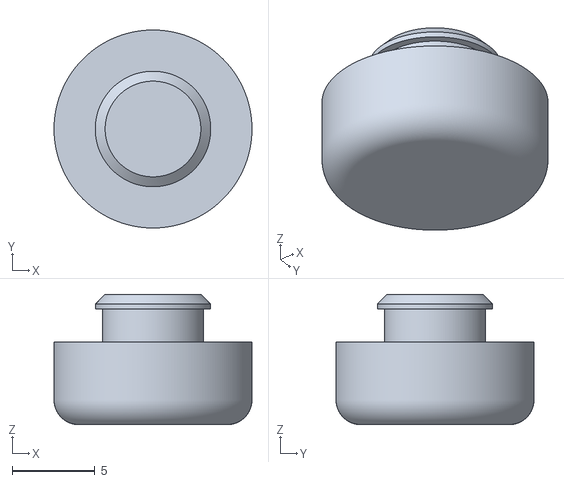
[picture p84: CAD file, 2026-11-14]
docs/hardware/gehaeuse/staender-v2/entwurf-1/TPU_Fuss_4x.stl
12.0 x 12.0 x 7.90
