ma-t-thias/ESP32-LED-Kopfhoererstaender/docs/hardware/gehaeuse/staender-v2/entwurf-1/Inlay_Saeule.stl

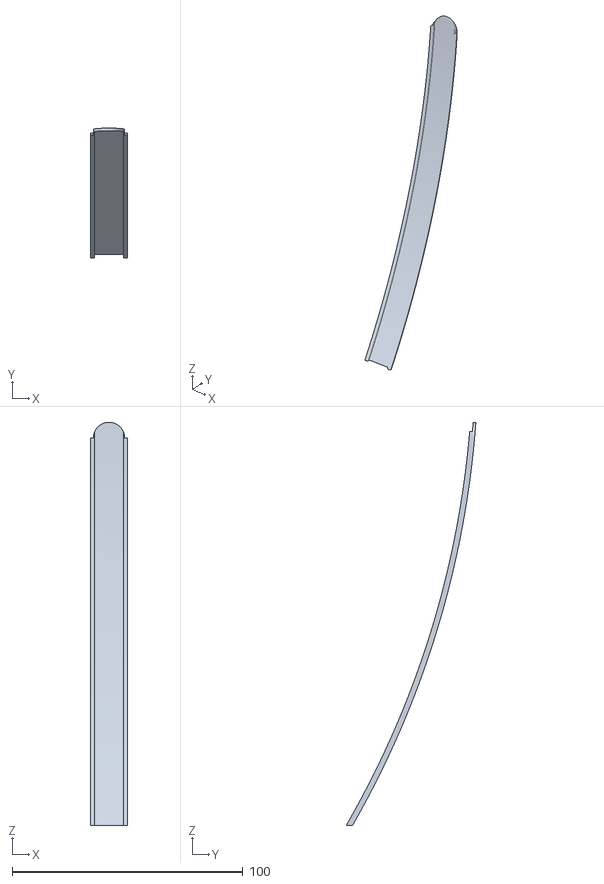
[picture p85: CAD file, 2026-11-14]
docs/hardware/gehaeuse/staender-v2/entwurf-1/Inlay_Saeule.stl
16.0 x 56.3 x 174.8
