ma-t-thias/ESP32-LED-Kopfhoererstaender/(list of files, cad)

Other CAD files:
docs/hardware/gehaeuse/staender-v2/entwurf-1/Inlay_Front_rechts.stl
