ma-t-thias/ESP32-LED-Kopfhoererstaender/(commit log)

2026-11-01 Firmware fuer die WLAN-LED-Steuerung und Hardware-Doku
    - PlatformIO-Projekt fuer Waveshare ESP32-C6-LCD-1.3 (pioarduino, 4 MB Flash)
    - 16 Effekte und 8 Paletten mit FastLED, Datenpin GPIO1, Stromgrenze einstellbar
    - Weboberflaeche mit Farben, Paletten, Tempo, Intensitaet; JSON-API
    - WLAN-Einrichtung ueber eigenes Einrichtungs-WLAN, Zugangsdaten nur im Flash
    - Statusanzeige mit LED-Vorschau auf dem LCD, BOOT-Taster fuer Effektwechsel
    - Schaltplan, Breadboard-Belegung und Bauteilliste unter docs/hardware
    Claude-Session: https://claude.ai/code/session_01GN2BkTnwmeb155U63FM4of
2026-11-01 PC-Sync: Farben von SignalRGB/OpenRGB uebernehmen
    - Echtzeit-Empfang ueber DDP (4048), E1.31/sACN (5568) und WLED-UDP (21324)
    - Ohne Daten vom PC nach 2,5 s automatisch zurueck zu den eigenen Effekten
    - WLED-kompatible Erkennung: mDNS _wled._tcp, /json/info, /json/state
    - Schalter und Statusanzeige in Weboberflaeche und auf dem Display
    - README: Einrichtung in SignalRGB und OpenRGB
    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
2026-11-01 ARGB-Eingang: ASUS Aura steuert den Staender ueber das Mainboard-Kabel
    - RMT-Empfang an GPIO2 liest das WS2812-Signal eines Mainboard-ARGB-Headers mit
    - LED-Anzahl wird erkannt und auf 144 LEDs gestreckt
    - Ohne gueltiges Signal nach 2 s zurueck zu den eigenen Effekten
    - Vorrang: Mainboard-Kabel vor PC-Sync per WLAN vor eigenen Effekten
    - Schalter in der Weboberflaeche, Anzeige "Aura (n LEDs)" auf dem Display
    - Schaltplan, Breadboard-Belegung und Bauteilliste um Spannungsteiler und Kabel ergaenzt
    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
2026-11-01 Absturz-Schleife durch ARGB-Eingang beheben, WLAN-Diagnose
    Der RMT-Empfang mit en_partial_rx loest unter IDF 5.4 sporadisch
    "assert failed: rmt_isr_handle_rx_done (offset >= rx_chan->mem_off)" aus.
    Der ESP startete dadurch immer wieder neu, was wie ein WLAN-Problem aussah.
    - ARGB-Eingang ab Werk aus, RMT-Kanal wird erst beim Einschalten angelegt
    und beim Ausschalten freigegeben (neuer Einstellungs-Schluessel argb2)
    - Absturz waehrend des Empfangs sperrt den Eingang fuer den naechsten Start
    - WLAN: Stromsparen aus, Abbruchgrund und Neustartgrund auf Display, Seite
    und seriell; Einrichtungs-WLAN erst nach 10 s stabiler Verbindung aus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
    [argb_in.cpp, argb_in.h, display.cpp, display.h, main.cpp, net.cpp, settings.cpp, state.h]
2026-11-01 Versorgung über USB-C-Netzteil 5 V / 3 A
    - Schaltplan, Breadboard-Zeichnung und Bauteilliste: USB-C-Netzteil
    5 V / 3 A mit USB-C-Buchse (5,1 kOhm an CC1/CC2) statt Hohlstecker
    - Streifen wird auf 60 bis 70 cm gekuerzt (ca. 100 LEDs), Dimensionierung
    angepasst, Sicherung 4 A
    - Startwert der Stromgrenze 2400 mA, README angepasst
    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
2026-11-01 Anzeige in der Weboberfläche drehen (0/90/180/270 Grad)
    - Neue Einstellung "Anzeige drehen" in der Weboberfläche, Feld rot (0..3)
    in /api/state, im Flash gespeichert (Schlüssel rot)
    - Display zeichnet beim Wechsel komplett neu
    - Zeilenversatz 80 für 180/270 Grad (240x240-Panel am 240x320-Controller)
    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
2026-11-01 Neue Weboberfläche im Apple-Stil mit Live-Vorschau und Presets
    - Seite neu gestaltet: Glas-Karten über einem Lichtschein in den LED-Farben,
    Live-Streifen mit Spiegelung, Farbrad, Effekt-Kacheln mit animierter
    Vorschau, Regler und Schalter im iOS-Stil, Hell- und Dunkelmodus
    - Quelle in web/index.html, tools/web2h.py erzeugt src/webui_index.h
    - /api/live liefert die aktuellen LED-Farben für die Vorschau
    - /api/presets speichert Presets im Flash (Namespace "presets")
    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
2026-11-01 README: Bilder der neuen Weboberfläche
    Drei Bildschirmfotos (Handy hell und dunkel, PC dunkel) in docs/images,
    im README oben eingebunden. Startbild der Demo auf Plasma geändert.
    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
2026-11-01 WLED-kompatible Schnittstelle für Home Assistant und WLED-App
    - neues Modul src/wled_api.cpp (ArduinoJson 7.2.1): /json, /json/si,
    /json/info, /json/state (GET und POST), /json/eff, /json/pal,
    /json/fxdata, /presets.json
    - POST /json/state übernimmt on, bri, ps (Preset), udpn.recv (PC-Sync)
    und im Segment col, fx, sx, ix, pal, bri, on
    - Startpresets in der Firmware, bis eigene gespeichert werden
    - mDNS-TXT "mac" für die automatische Erkennung in Home Assistant
    - README: Abschnitt Home Assistant und WLED-App
    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
2026-11-01 Weboberfläche in drei Seiten mit Tab-Leiste aufteilen
    Licht (Presets, Tempo, Effekte), Farben (Farbrad, Paletten) und
    Einstellungen (Aura, Sync, Stromgrenze, Drehung, Gerät, WLAN). Kopf,
    Live-Streifen und Helligkeit bleiben oben sichtbar. Schwebende
    Tab-Leiste unten, Seiten per #licht/#farben/#einst erreichbar, die
    letzte Seite merkt sich der Browser. README-Bilder erneuert.
    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
2026-11-01 Matter-Prototyp für Apple Home, Google Home und Alexa
    Matter-Farblampe (Ein/Aus, Helligkeit, Farbe, Weißton) über den
    Arduino-Core, ab Werk aus und in der Weboberfläche einschaltbar.
    Display zeigt QR-Code und Koppel-Code, solange nicht gekoppelt.
    Änderungen aus Weboberfläche und Taster werden an Matter gemeldet.
    Eigene Partitionstabelle mit 128 KB NVS für die Matter-Daten.
    Nutzt die Test-Zugangsdaten des Arduino-Cores (VID 0xFFF1).
    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
    [partitions.csv]
2026-11-01 Firmware passt wieder in den App-Bereich, Update per WLAN für den Test
    Mit Matter war die Firmware größer als ein Update-Slot (1,97 MB), der
    Bootloader fand kein startbares Programm und das Display blieb dunkel.
    Die Größenprüfung griff nicht, weil maximum_size auf 4 MB stand.
    - Matter nur noch in env:esp32-c6-lcd-matter (eigene Partitionstabelle
    mit 3,75 MB App-Bereich, ohne Update per WLAN)
    - Standard-Firmware ohne Matter: 1,2 MB, zwei Update-Slots
    - maximum_size passend zur Partition, PlatformIO bricht sonst ab
    - Weboberfläche blendet Matter aus, wenn ohne Matter gebaut
    - test_ota.example.ini: lokale Umgebungen test-usb/test-ota für Update
    per WLAN im Testbetrieb, test_ota.ini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
    [partitions_matter.csv]
2026-11-02 Gehäuse für das ESP32-C6-LCD-1.3 im Ständer ablegen
    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
    [Base_Box_ESP32.stl, ESP32_Lid.stl, RGB Headphone Stand - Baugruppe.3mf, RGB Headphone Stand - ESP32.3mf]
2026-11-03 Gehäuse für das ESP32-C6-Touch-LCD-1.9 in zwei Varianten (hochkant/quer)
    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
    [Base_Box_ESP32.stl, Base_Box_ESP32_quer.stl, Baugruppe_quer.3mf, ESP32_Lid.stl, ESP32_Lid_quer.stl, ESP32_quer.3mf, RGB Headphone Stand - Baugruppe.3mf, RGB Headphone Stand - ESP32.3mf]
2026-11-05 Firmware auf das ESP32-C6-Touch-LCD-1.9 portieren
    Standardboard ist jetzt das Waveshare ESP32-C6-Touch-LCD-1.9:
    - Display 170x320 (ST7789, Offsets 35/0, Hintergrundlicht LOW = an),
    Anzeige ordnet sich fuer Hoch- und Querformat selbst an
    - Touch CST816D: Tippen = naechster Effekt (wie BOOT-Taster)
    - LED-Daten auf GPIO3, ARGB-Eingang auf GPIO23 (GPIO1/2 sind IMU-Interrupts)
    - 8 MB Flash, Partitionstabelle unveraendert
    Das alte ESP32-C6-LCD-1.3 baut env:esp32-c6-lcd-13.
    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
2026-11-06 Elektroplan auf ESP32-C6-Touch-LCD-1.9 umgestellt
    Schaltplan, Breadboard-Belegung, Verdrahtungstabelle, Bauteilliste und
    Pinbelegung zeigen jetzt das neue Board: VBUS an J4 Pin 1 über D1,
    LED-Daten GPIO3 (J3 Pin 7), ARGB-Eingang GPIO23 (J4 Pin 9).
    Breadboard: ESP in Reihe 1-20 (Spalten c/h), 74AHCT125 in Reihe 23-29.
    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
2026-11-06 Display dreht sich automatisch nach dem Lagesensor
    Neue Einstellung Anzeige drehen = Auto (Standard auf dem 1.9er): der
    QMI8658 liefert die Schwerkraft, daraus folgt die Drehung 0..3. Die
    manuelle Drehung bleibt waehlbar. Zuordnung der Sensorachsen in
    config.h (IMU_ROT_*), Serial zeigt ax/ay zur Kontrolle.
    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
2026-11-06 Auto-Drehung: Achszuordnung um 90 Grad korrigiert
    Am echten Board stand das Bild bei Auto um 90 Grad gegen den
    Uhrzeigersinn verdreht; jede Lage dreht jetzt eine Stufe weiter.
    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
    [config.h]
2026-11-06 Touch: Wischen links/rechts wechselt den Effekt
    Wischen nach rechts = naechster, nach links = vorheriger Effekt, Tippen
    bleibt naechster Effekt. Die Richtung wird mit der aktuellen
    Displaydrehung (auch Auto) in Bildkoordinaten umgerechnet.
    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
2026-11-06 Touch: Tippen in die untere Haelfte wechselt die Palette
    Tippen oben = naechster Effekt wie bisher, unten = naechste Palette.
    Oben/unten gilt im angezeigten Bild, passend zur Drehung.
    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
2026-11-06 Touch: Tippen unten wechselt bei Farbeffekten die Farbe
    Bei Effekten mit Farbe 1/2 (Einfarbig, Atmen, Komet, Kerze ...) waehlt
    Tippen in die untere Haelfte die naechste von neun Farben, Farbe 2 liegt
    gegenueber. Bei allen anderen Effekten weiter die naechste Palette.
    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
2026-11-06 Matter in der Standard-Firmware des 1.9er-Boards
    Mit 8 MB Flash passen Matter und zwei App-Slots fuer Updates per WLAN
    zusammen (partitions_8mb.csv, je 3,75 MB). NVS bleibt an derselben
    Stelle, WLAN-Daten und Einstellungen bleiben erhalten. Die eigene
    Matter-Umgebung entfaellt; das alte 1.3er-Board bleibt ohne Matter.
    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
    [partitions.csv, partitions_8mb.csv, partitions_matter.csv]
2026-11-07 Gehäuse: Rastdeckel v2 für C6-Touch-LCD-1.9 (hochkant und quer)
    Deckel mit Steckkragen über die ganze Tiefe (22,70 mm, Spiel ca. 0,075 mm
    pro Seite), zwei Rastzungen an der Rückwand und Hebelkerbe. Grundkörper
    mit Rastnuten. STL/3MF, SolidCraft-Modelle (ohne Board-STEP) und neue
    Bilder für beide Varianten, README um Rastdeckel und Druckhinweise ergänzt.
    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
    [Base_Box_ESP32.stl, Base_Box_ESP32_quer.stl, Baugruppe_quer.3mf, ESP32_Lid.stl, ESP32_Lid_quer.stl, ESP32_quer.3mf, RGB Headphone Stand - Baugruppe.3mf, RGB Headphone Stand - ESP32.3mf]
2026-11-07 Breadboard-Belegung auf zwei übereinander gesteckte Boards umgestellt
    Das Display des 1.9er-Boards steht seitlich über, darum überspannt der ESP
    jetzt zwei BB-801: J4 in Board 1 Spalte a, J3 in Board 2 Spalte j.
    Zugriff über Board 1 e1/e3/e9 und Board 2 f7. D1 über den Mittelkanal
    (f1/e1), IO3 von Board 2 f7 zu g28, IO23 von e9 zu h21.
    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
2026-11-07 USB-C-Breakout QUARKZMAN auf Board 2 eingezeichnet
    Buchse steckt in Board 2 Spalte a, Reihe 23 (GND) bis 30 (CC2).
    VBUS und GND per Litze oben an die Stifte gelötet direkt zu den
    WAGO-Klemmen, damit kein LED-Strom über die Breadboard-Kontakte fließt.
    Stückliste und Verdrahtungstabelle angepasst.
    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
2026-11-07 Stromschienen von Board 1 richtig herum gezeichnet
    Jede Schiene hat − neben Spalte a bzw. außen oben und + daneben, so wie
    auf den echten BB-801: von unten gelesen +, −, a…e, f…j, +, −, a…e, f…j, +, −.
    Obere Schiene: − außen, + neben j. Mittlere Schiene: − neben a, + außen.
    Brücken zu den äußeren Schienenreihen laufen versetzt zwischen den Löchern.
    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
2026-11-07 Gehäuse: Frontfixierung mit Einhängenase und Rastzungen an den Stirnwänden
    Deckel beider Varianten (hochkant und quer): zwei Einhängenasen vorne
    greifen in Taschen in der Frontwand, die Rastzungen sitzen jetzt an den
    Stirnwänden hinten in den Ecken statt an der Rückwand. Hochkant gedruckt
    und getestet (rastet hörbar ein, kein Spiel), quer rechnerisch geprüft.
    Druckdateien, SolidCraft-Modelle (ohne Board-STEP), neue Bilder und
    README-Abschnitt Frontfixierung (7.11.2026).
    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
    [Base_Box_ESP32.stl, Base_Box_ESP32_quer.stl, Baugruppe_quer.3mf, ESP32_Lid.stl, ESP32_Lid_quer.stl, ESP32_quer.3mf, RGB Headphone Stand - Baugruppe.3mf, RGB Headphone Stand - ESP32.3mf]
2026-11-08 Einseitige Platine für den Sockel
    Bedrahtete Bauteile, selbst ätzbar: 74AHCT125, D1, R1, R3/R4, C2 und
    Lötpads für USB-C, LED-Streifen, ESP und ARGB-Eingang. Umriss und
    Befestigungslöcher passen in die Mitte des Sockels zwischen den
    Diffusorscheiben. Das Skript erzeugt Gerber, Bohrdatei, 1:1-Ätzvorlage
    und Bestückungsplan und prüft Abstände und die Massefläche.
    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
    [platine-B_Cu.gbl, platine-Edge_Cuts.gm1, platine.drl]
2026-11-08 Platine: C2 als Folienkondensator CY630 104J (Raster 10,16 mm) liegend ueber U1
    USB-Pads 1,5 mm nach innen, damit die Massefläche zusammenhängt.
    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
    [platine-B_Cu.gbl, platine.drl]
2026-11-08 Platine: C1 1000 uF (Ø8 x 11,5) liegend an der USB-Einspeisung
    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
    [platine-B_Cu.gbl, platine.drl]
2026-11-08 Platine: C2 (CY630) stehend unter U1, Unterkante auf y -11,8 erweitert
    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
    [platine-B_Cu.gbl, platine-Edge_Cuts.gm1, platine.drl]
2026-11-08 Platine: Zunge verlängert, vorhandener C1 (Ø8,2 x 16,7) liegend, D1 zum ESP-Anschluss, Dom auf (0/30)
    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
    [platine-B_Cu.gbl, platine-Edge_Cuts.gm1, platine.drl]
2026-11-08 Platine: D1 0,3 mm nach unten (Abstand zur ESP-Stiftleiste)
    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
    [platine-B_Cu.gbl, platine.drl]
2026-11-08 Platine: D1 mit Abstand zur ESP-Stiftleiste (Zunge links verbreitert), U1 1,5 mm nach links, R1 0,5 mm nach rechts
    Nach Probedruck: Diode und R1 standen zu dicht an Stiftleiste bzw. U1.
    Claude-Session: https://claude.ai/code/session_01GN2BkRmabsgeYyDYiBonZ3
    [platine-B_Cu.gbl, platine-Edge_Cuts.gm1, platine.drl]
2026-11-09 Platine: Fertigungsdaten fuer Leiterplatten-Shops (Gerber-ZIP)
    Kupfer oben (Loetaugen, durchkontaktiert) und unten, Loetstopplack beidseitig,
    Bestueckungsdruck mit Bauteilnamen und Polung, Bohrdateien PTH/NPTH getrennt,
    Vorschau. Gerber mit gerbonara geprueft. Aetzvorlage unveraendert.
    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
    [platine-B_Cu.gbl, platine-B_Mask.gbs, platine-Edge_Cuts.gm1, platine-F_Cu.gtl, platine-F_Mask.gts, platine-F_SilkS.gto, platine-NPTH.drl, platine-PTH.drl]
2026-11-09 Platine: ARGB-Anschluss im Raster des Mainboard-Steckers (5V, D, Luecke, G)
    5V-Pad nur mechanisch, nicht angeschlossen. Bestueckungsdruck beschriftet.
    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
    [platine-B_Cu.gbl, platine-B_Mask.gbs, platine-F_Cu.gtl, platine-F_Mask.gts, platine-F_SilkS.gto, platine-PTH.drl]
2026-11-09 Platine: ARGB-Anschluss an die schraege Kante fuer 90-Grad-Stiftleiste
    Reihe parallel zur Kante x+y=24,7, 1,8 mm eingerueckt: 5V(nc), D, Luecke, G.
    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
    [platine-B_Cu.gbl, platine-B_Mask.gbs, platine-F_Cu.gtl, platine-F_Mask.gts, platine-F_SilkS.gto, platine-PTH.drl]
2026-11-09 PC-Sync ueber USB-C: Adalight-Empfang und USB-Datenleitungen auf der Platine
    Firmware: realtime liest Adalight-Rahmen von der USB-Schnittstelle (OpenRGB
    Serial LED Strip, Prismatik, Hyperion), auch ohne WLAN; RX-Puffer 2 KB.
    Platine: D+/D- der Sockel-Buchse ueber Loetbruecken SJ1/SJ2 (oben, SMD) zu
    neuen Pads fuer J3 Pin 11/12 (GPIO12/13). Bahnen auf der Oberseite.
    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
    [platine-B_Cu.gbl, platine-B_Mask.gbs, platine-F_Cu.gtl, platine-F_Mask.gts, platine-F_SilkS.gto, platine-PTH.drl]
2026-11-10 Platine: USB-C ueber zwei JST-XH-2P steckbar (Strom, Daten) statt Loetbruecken
    Das Datenkabel ist der Schalter fuer PC-Sync. Doku, Breadboard-Plan und
    Schaltplan um die optionale USB-Datenverbindung ergaenzt.
    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
    [platine-B_Cu.gbl, platine-B_Mask.gbs, platine-F_Cu.gtl, platine-F_Mask.gts, platine-F_SilkS.gto, platine-PTH.drl]
2026-11-10 Platine: USB-C-Anschluesse auf 2,54-mm-Stiftleisten statt JST-XH
    Wunsch: ueberall dieselben Standard-Stiftleisten (gerade oder 90 Grad) mit
    Dupont-Kabeln. Abstands- und Masse-Pruefung ohne Befund, Gerber neu.
    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
    [platine-B_Cu.gbl, platine-B_Mask.gbs, platine-F_Cu.gtl, platine-F_Mask.gts, platine-F_SilkS.gto, platine-PTH.drl]
2026-11-10 Platine: alle Anschluesse als 2,54-mm-Stiftleisten (LED 1x3, ESP D+/D- 1x2)
    R1 0,4 mm nach links fuer Platz zum Dupont-Gehaeuse, GND-Bruecke oben
    (U1 Pin 4 -> 1) haelt die Masseflaeche zusammen. Doku angepasst.
    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
    [platine-B_Cu.gbl, platine-B_Mask.gbs, platine-F_Cu.gtl, platine-F_Mask.gts, platine-F_SilkS.gto, platine-PTH.drl]
2026-11-10 Platine: Anschluesse im Bestueckungsdruck beschriftet (LED, ARGB, ESP32, USB-C)
    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
    [platine-F_SilkS.gto]
2026-11-10 Platine: Copyright im Bestueckungsdruck, Doku zu Anschluessen im Sockel ergaenzt
    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
    [platine-F_SilkS.gto]
2026-11-10 Sockel: USB-C-Halter v2, Platinen-Dome und Elektronik in den Baugruppen
    - Base_Box_ESP32 hochkant und quer: USB-C-Halter v2 (Durchbruch 13,0 x 7,2 mm
    mit Fase 0,6, Dome und Pad für die Buchsenplatine, Stützleiste 1,0 mm unter
    der Platine), Stops um 0,75 mm gekürzt, drei Platinen-Dome M2,5
    (-5/-6, 27,5/-1, 0/30; Oberkante z 4, Kernloch 2,2 x 3), alte Kabelbohrung
    unterdrückt. STL/3MF neu exportiert.
    - Baugruppen hochkant und quer: Gruppe "Elektronik" mit Platine (Stand
    platine-stiftleiste), Bauteilen, 2,54-mm-Stiftleisten, Dupont-Steckern an
    USB-Strom/-Daten, USB-C-Buchsenplatine mit 8er-Leiste und ARGB-Stecker.
    - ESP32.sc hochkant: Gruppe "Elektronik (Vorschau)" mit Beschrift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
    [Base_Box_ESP32.stl, Base_Box_ESP32_quer.stl, Baugruppe_quer.3mf, ESP32_Lid.stl, ESP32_Lid_quer.stl, ESP32_quer.3mf, RGB Headphone Stand - Baugruppe.3mf, RGB Headphone Stand - ESP32.3mf]
2026-11-10 Platine: Copyright (C) 2026 Matthias Steis, Kleinbuchstaben im Bestueckungsdruck
    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
    [platine-F_SilkS.gto]
2026-11-10 Platine: Massefläche durchgehend (3 GND-Brücken oben), Bohrungen 1,0 für Signal-Stiftleisten, Doku ergänzt
    - Robuste GND-Inselprüfung, R1 nach x 19,8, drei GND-Brücken auf der Oberseite
    - C2 leicht verschoben, Lötstopp-Lagen negativ, DIN-Beschriftung an der LED-Leiste
    - README: Selbstätzen mit 3 Drahtbrücken, Bohrliste, Bahnbreiten, ARGB-Stift vorher ziehen,
    Schraubenkopf am Loch (0/30), Stückliste, Gerber-Format; Haupt-README verlinkt
    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
    [platine-B_Cu.gbl, platine-B_Mask.gbs, platine-F_Cu.gtl, platine-F_Mask.gts, platine-F_SilkS.gto, platine-PTH.drl]
2026-11-10 Gehäuse-Doku: Anschlüsse LED/ESP und Stops als entschieden eingetragen
    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
2026-11-11 Weboberfläche: an Apple Human Interface Guidelines angepasst
    Feste Akzentfarbe (systemBlue) für Auswahl, Tabs und Fokus, LED-Farbe nur
    für Inhalte; Systemfarben hell/dunkel (Rot, Orange, Segment); Dynamic Type
    (rem + -apple-system-body); Transparenz reduzieren und Kontrast erhöhen;
    Trefferflächen ab 44 pt; Chips mit lesbarem Text; Anzeige-drehen-Segmente
    in eigener Zeile; Presets per langem Drücken löschbar (iOS kennt kein
    contextmenu); Farbfelder öffnen den System-Farbwähler.
    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
2026-11-11 Weboberfläche: Verbesserungen aus paralleler Überarbeitung übernommen
    Verbindungsanzeige mit Neuversuch und 4-s-Timeout, Druck-Feedback an
    Schaltern/Paletten/Listen, größere Trefferflächen, Safe-Area links/rechts,
    kein Doppeltipp-Zoom, Hover nur mit Maus, Langdruck nur bei Touch.
    Zweite Prüfung: Timeout, Android-Langdruck und Listenecken behoben.
    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
2026-11-11 Display: Startbild beim Einschalten (6 s) und beim Update mit Fortschrittsbalken
    Kopfhoerer mit Regenbogen-Buegel, LED-Reihe und Name, nur mit Grafikbefehlen
    gezeichnet (hochkant, quer, 240x240). LEDs und WLAN starten waehrenddessen.
    OTA: Fortschritt in Prozent, bei Fehler Meldung und Neustart.
    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
2026-11-11 Versionskennung (Git-Tag + Hash) im Startbild, in der Weboberflaeche und in /api/info
    tools/version.py schreibt beim Bauen include/fw_version.h (nicht eingecheckt),
    nur bei Aenderung. Anzeige: Startbild, Einstellungen -> Geraet -> Firmware,
    /api/info Feld fw, serieller Monitor. README erklaert Tags.
    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
2026-11-11 Start- und Update-Bild: Copyright, Ladebalken mit Farbverlauf, drehende Sanduhr mit Prozent
    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
2026-11-11 Copyright und Lizenz (CC BY-NC-SA 4.0): LICENSE.md, README, Weboberflaeche 'Ueber dieses Projekt' mit Herkunft und Rechtlichem
    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
2026-11-11 Display zeigt im Aus-Zustand das Logo, erste Beruehrung schaltet nur ein
    Ausgeschaltet (Web, Matter) erscheint das Startbild mit Hinweis statt der
    Statusseite. Tippen/Wischen oder kurzer BOOT-Druck schaltet dann nur ein,
    ohne Effekt oder Farbe zu wechseln. Koppeln und WLAN-Einrichtung gehen vor.
    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
2026-11-11 Weboberflaeche: Ueber dieses Projekt auf eigene Seite Info
    Vierter Tab Info (#info) in der unteren Leiste, Abschnitt aus den
    Einstellungen dorthin verschoben. README angepasst.
    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
2026-11-11 Weboberflaeche: Geraetedaten mit Firmware-Version auf die Info-Seite
    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
2026-11-12 Display: Zahnrad oeffnet Einrichten-Seite mit Reglern und Netzdaten
    Touch liefert jetzt die Fingerposition. Oben rechts ein Zahnrad, dahinter
    Schieberegler fuer Helligkeit, Tempo und Effekt-Staerke (Beschriftung je
    Effekt) sowie IP, Hostname, WLAN und Firmware. Mit WLAN ist die Startseite
    aufgeraeumt (ohne Netzzeilen, groessere Vorschau). 1.3er ohne Touch unveraendert.
    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
2026-11-12 Firmware-Update ueber die Weboberflaeche, Update-Datei nur fuer getaggte Staende
    - POST /api/update: Upload der .bin, prueft Board-Kennung im Dateinamen (LCD19/LCD13),
    ESP32-C6-Image-Kopf und Pruefsumme; Fortschritt mit Sanduhr am Display, danach Neustart.
    Abgebrochener Upload startet sauber neu, ohne Datei kein Erfolg.
    - Weboberflaeche: Info -> Firmware-Update mit Dateiauswahl und Fortschrittsbalken.
    - tools/update_file.py: PlatformIO-Aufgabe "Update-Datei erzeugen", nur bei Tag auf HEAD
    und ohne lokale Aenderungen, sonst Meldung und keine Datei.
    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
2026-11-12 Web-Update erst nach Bestaetigung am Display, Tag-Pruefung vor dem Bauen
    - Display fragt "Update?" (Erlauben/Ablehnen, altes Board: BOOT-Taste), 60 s;
    Erlaubnis gilt 2 min fuer genau die anfragende Seite (Token).
    - Upload wird ohne Erlaubnis abgelehnt; waehrend der Frage kein Effektwechsel per Touch.
    - update_file: Tag-Pruefung schon vor dem Kompilieren.
    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
2026-11-12 Web-Update prueft freien Speicher, Version immer mit Commit-Hash
    - /api/info liefert fwMax (Groesse des freien App-Slots)
    - Browser prueft die Dateigroesse vor der Frage am Display, der Staender
    bei /api/update/ask?size= (413) und beim Upload (Update.begin(size))
    - tools/version.py schreibt zusaetzlich FW_HASH und FW_FULL, z. B.
    "V1.0.0 (1a2b3c4)"; Display, Weboberflaeche und Seriell zeigen FW_FULL
    - FW_VERSION bleibt git describe (Tag-Vergleich in update_file.py)
    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
2026-11-12 Partitionstabelle: otadata auf 0xE000, damit USB-Upload nach Web-Update wirkt
    PlatformIO schreibt boot_app0.bin beim USB-Upload fest auf 0xE000. otadata
    lag bei 0x9000: Nach einem Web-Update startete der ESP deshalb auch nach
    USB-Uploads weiter die alte Firmware aus app1, und boot_app0 ueberschrieb
    8 KB der fctry-Partition. Jetzt fctry 0x9000 (0x5000), otadata 0xE000.
    nvs und App-Slots unveraendert. Einmal per USB flashen.
    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
    [partitions.csv, partitions_8mb.csv]
2026-11-12 Update-Anzeige: kreisendes Warte-Symbol statt Sanduhr
    8 Striche im Kreis, der hellste wandert im Uhrzeigersinn (110 ms je
    Schritt). README angepasst.
    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
2026-11-12 Warte-Symbol beim Update in der Kopfhoerer-Grafik, Prozent mittig darunter
    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
2026-11-12 Geraetepasswort fuer die Weboberflaeche und Werkseinstellungen
    - Zufaelliges Passwort (8 Zeichen) beim ersten Start, im NVS; steht am
    Display (Einrichten bzw. Startanzeige beim 1.3er) und im seriellen Monitor
    - Alle aendernden Anfragen brauchen den Kopf X-Key; 5 Fehlversuche sperren
    die Adresse 30 s; WLAN-Auswahl ohne Passwort nur ueber das Einrichtungs-WLAN
    - WLED-Schnittstelle (Home Assistant, WLED-App) per Schalter ohne Passwort
    - Weboberflaeche: Anmelde-Blatt, Einstellungen -> Zugang (Passwort aendern,
    abmelden, WLAN neu einrichten, Werkseinstellungen)
    - BOOT 5 s halten und loslassen = WLAN-Reset, 10 s = Werkseinstellungen
    - README: Geraetepasswort, Bedienung, API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
    [display.cpp, main.cpp, net.cpp, settings.cpp, state.h]
2026-11-13 Selbsttest fuer die Fertigung und Seriennummer im Geraet
    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
2026-11-13 Doku: neue Bilder der Weboberflaeche (Licht, Farben, Einstellungen, Wartung, Info, PC)
    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
2026-11-13 Doku: Explosionszeichnungen von Staender und Sockel-Platine eingebunden
    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
2026-11-13 Doku: Screenshots zeigen die beschriebenen Bereiche, Begriffe vereinheitlicht
    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
2026-11-13 Lizenz Ständer korrigiert: Original NoycePrints (thing:3534573), CC BY-NC statt CC BY
    Laut LICENSE.txt im Thingiverse-Paket 4722406 ist der Grundkörper von
    NoycePrints und nicht kommerziell lizenziert. LICENSE.md, README,
    Gehäuse-README und Info-Seite der Weboberfläche angepasst.
    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
2026-11-13 Explosionszeichnung Staender: Fusszeile mit korrekter Herkunft und Lizenz
    Grundkoerper NoycePrints (thing 3534573), Remix FaisLeFr (4722406), CC BY-NC.
2026-11-14 Ständer v2: Entwurf 1 als Zwischenstand ablegen
    Neu konstruierter Ständer (ovaler Sockel, gebogene Säule, Auflage mit
    FSR-Druckplatte, Inlays aus fluoreszierendem PLA, TPU-Füße, Display-Deckel
    mit Mikrofonhalter). Ungetestet, eigene Konstruktion, CC BY-NC-SA 4.0.
    STL, SolidCraft-Dateien, Bilder, Druckliste und README in
    docs/hardware/gehaeuse/staender-v2/entwurf-1/, Verweis im Gehäuse-README.
    [Auflage_v2.stl, Boden_v1.stl, Druckplatte_FSR.stl, ESP32_Lid_Mikro_hochkant.stl, ESP32_Lid_Mikro_quer.stl, Inlay_Front_links.stl, Inlay_Front_rechts.stl, Inlay_Leuchtring.stl]
